haohao1331/ESC204-Team/milestone 2/Mechanical/Mechanical Build/Build Process before Milestone 1/2 Attaching Guide Rails.jpg

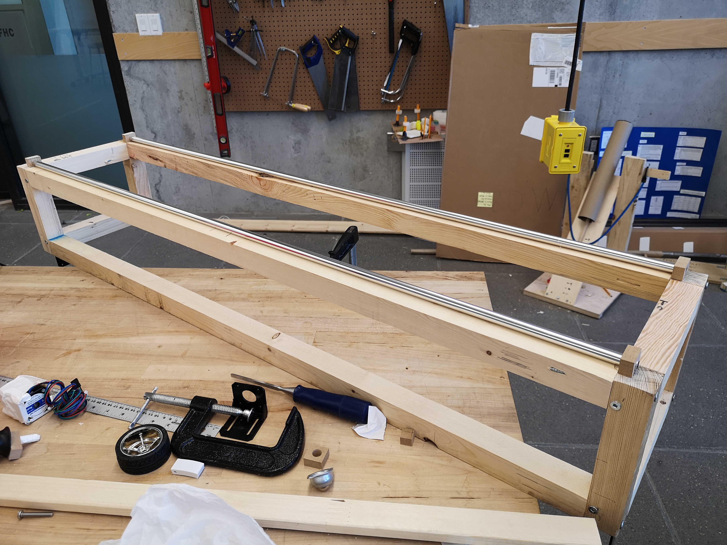
milestone 2/Mechanical/Mechanical Build/Build Process before Milestone 1/2 Attaching Guide Rails.jpg
