haohao1331/ESC204-Team/project proposal/camera testing/picam/test1/camera0.jpg

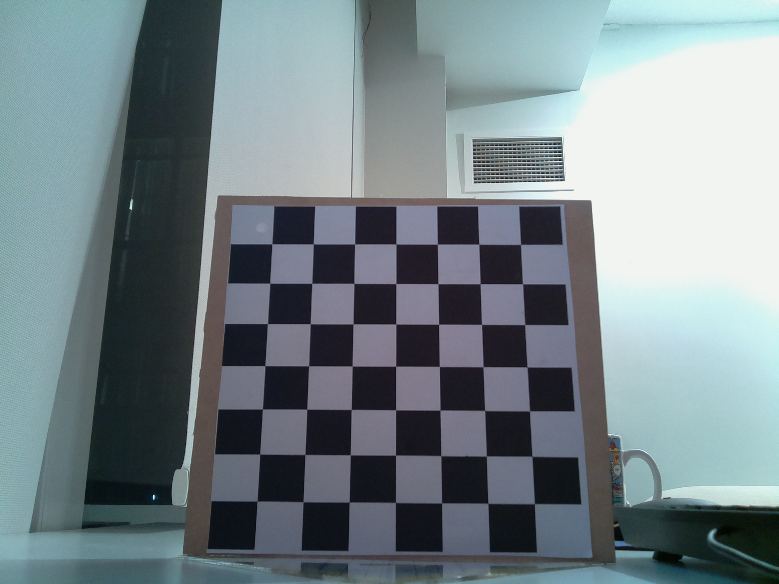
project proposal/camera testing/picam/test1/camera0.jpg
