haohao1331/ESC204-Team/README.md

# ESC204-Team
Team folder for ESC204, second year Engineering Science robotics course at U of Toronto. Files include design proposal, budget, python code for rhaspberry pi, CAD files.
