haohao1331/ESC204-Team/Design concept and project plan, informal presentation/Microcontroller selection.docx

# Microcontroller selection

## Metrics

Cost

Online resources

Compatability

CPU

RAM

Size

Power consumption
