haohao1331/ESC204-Team/Design concept and project plan, informal presentation/Project Timeline.xlsx

Week Starting Date | Week Number | Deliverables | Task to Accomplish
2020-02-03 | 5 |  | Finish Component Selection and start first round of purchasing.
2020-02-10 | 6 |  | Start to test component's performance
2020-02-17 | Reading Week | Design proposal | Start assembly, finish base, test camera recognition
2020-02-24 | 7 |  | Buy additional products, finish upper
2020-03-02 | 8 |  | Assembly, prepare for deliverable 1, be able to plug in under manual control
2020-03-09 | 9 | Milestone 1: Mobility | Prepare for deliverable 2
2020-03-16 | 10 | Milestone 2: Locating | Refine and further debug
2020-03-23 | 11 |  | Prepare for deliverable 3 and start report
2020-03-30 | 12 | Milestone 3: Final Design | Finsh report
2020-04-06 | 13 | Report, Video | Refine report before due date, finish a short video
Task assigment
Man Qiu | Designing and testing algorithms for computer vision
Richard | Desining and testing the base of the system
Leo | Designing and testing the upper body
