haohao1331/ESC204-Team/milestone 2/Electrical/motor driver connection.jpg

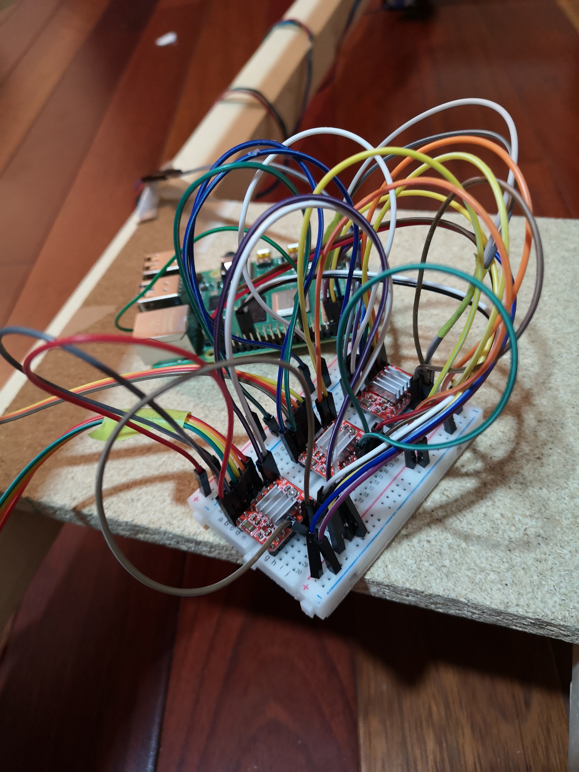
milestone 2/Electrical/motor driver connection.jpg
