haohao1331/ESC204-Team/milestone 2/Electrical/raspberry pi GPIO pins.jpg

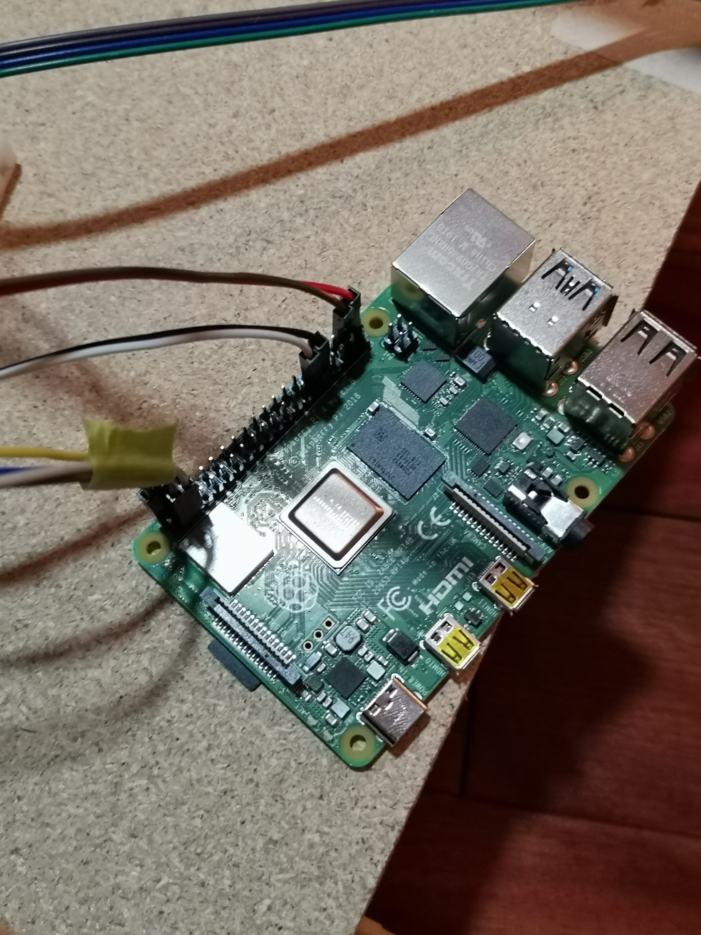
milestone 2/Electrical/raspberry pi GPIO pins.jpg
