haohao1331/ESC204-Team/milestone 2/Mechanical/Mechanical Build/Build Process before Milestone 1/18 Finished Design for Milestone 1.jpg

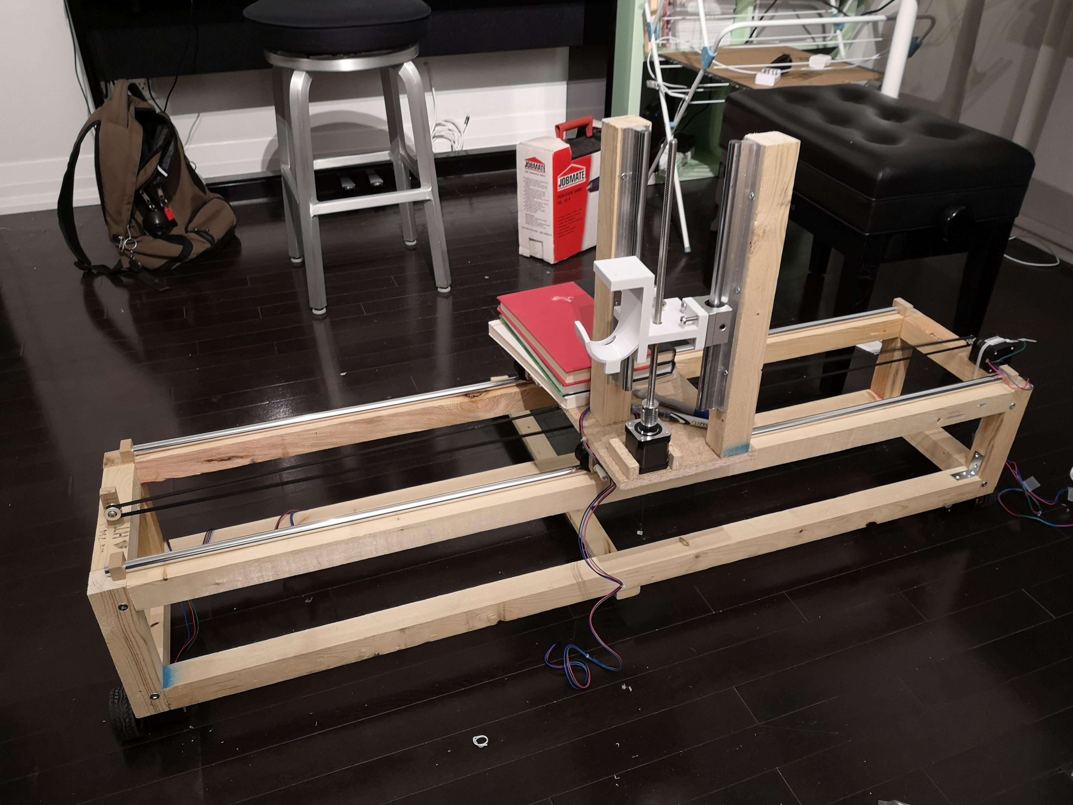
milestone 2/Mechanical/Mechanical Build/Build Process before Milestone 1/18 Finished Design for Milestone 1.jpg
