haohao1331/ESC204-Team/milestone 2/Mechanical/Mechanical Build/Final Mechanical Build/Finished Design for Milestone 2_5.jpg

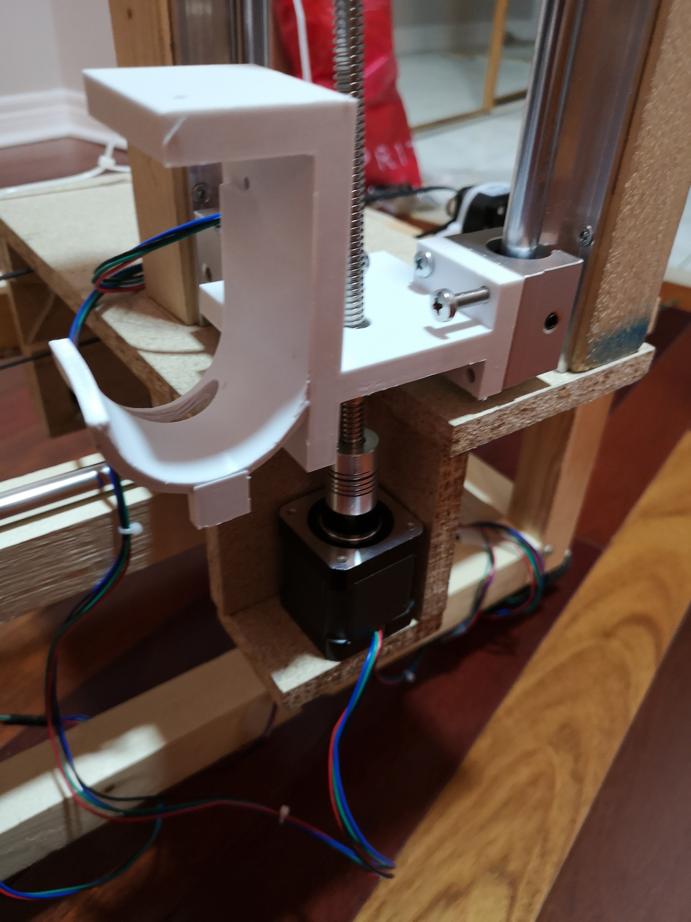
milestone 2/Mechanical/Mechanical Build/Final Mechanical Build/Finished Design for Milestone 2_5.jpg
