haohao1331/ESC204-Team/milestone 2/Mechanical/Mechanical Design/Gripper Design V1.0.jpg

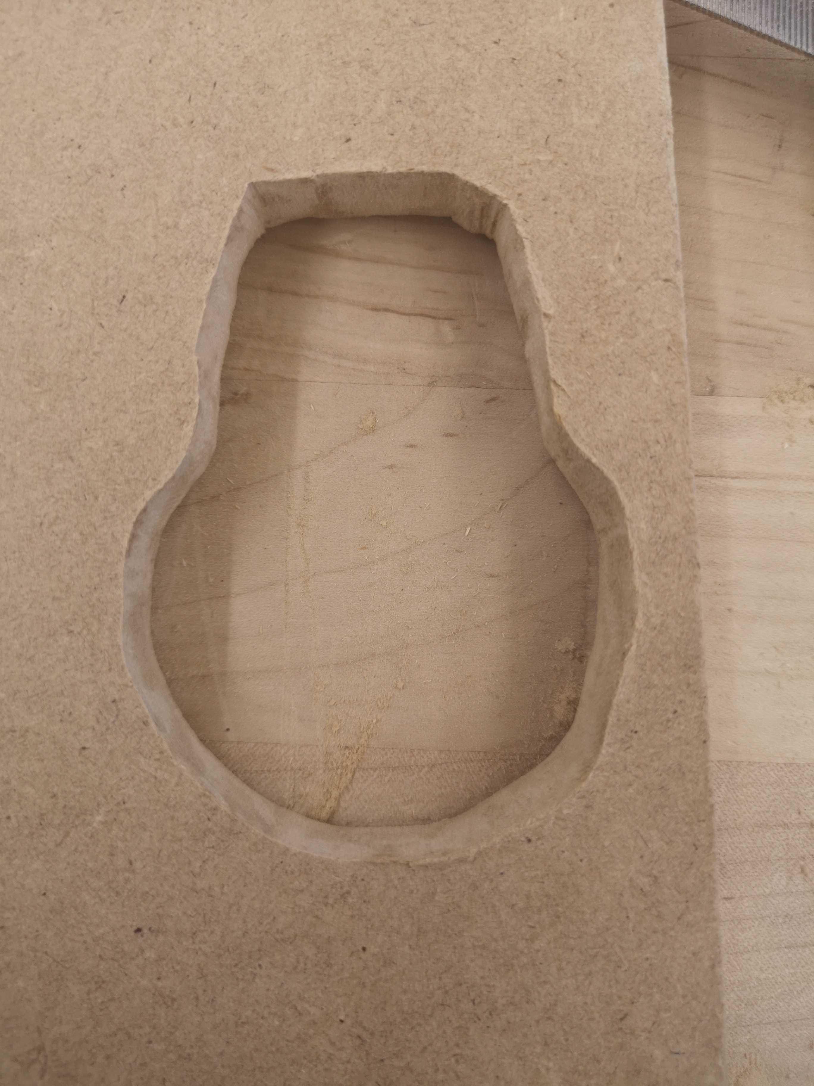
milestone 2/Mechanical/Mechanical Design/Gripper Design V1.0.jpg
