haohao1331/ESC204-Team/milestone 2/Mechanical/Storing and Transporting/Transporting the Finished Product.jpg

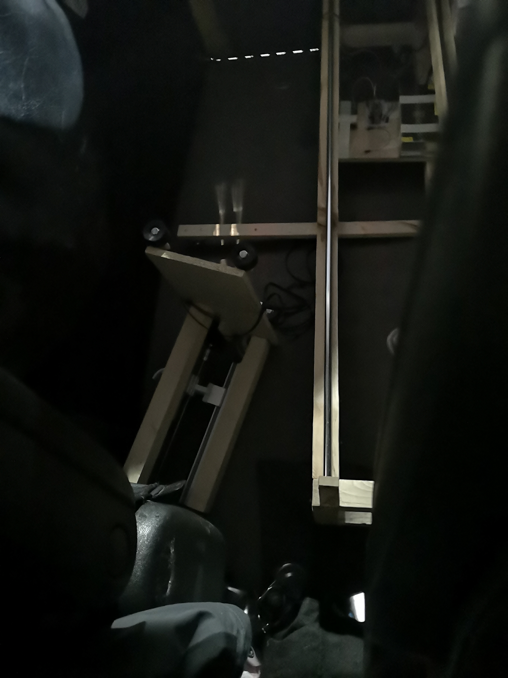
milestone 2/Mechanical/Storing and Transporting/Transporting the Finished Product.jpg
