haohao1331/ESC204-Team/milestone 2/Software/callibration.jpg

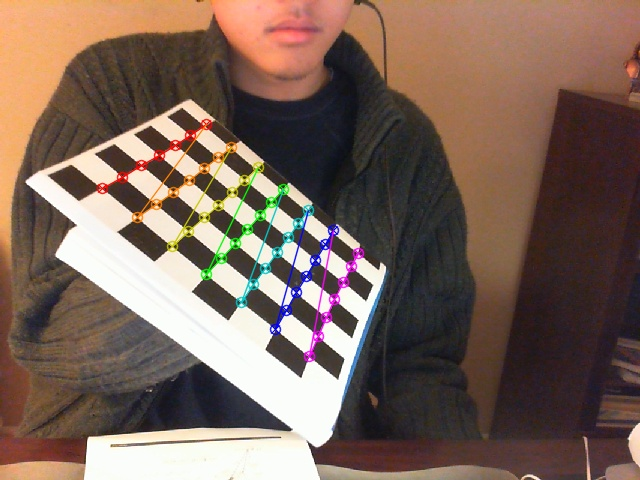
milestone 2/Software/callibration.jpg
