haohao1331/ESC204-Team/milestone 2/Software/sample output.PNG

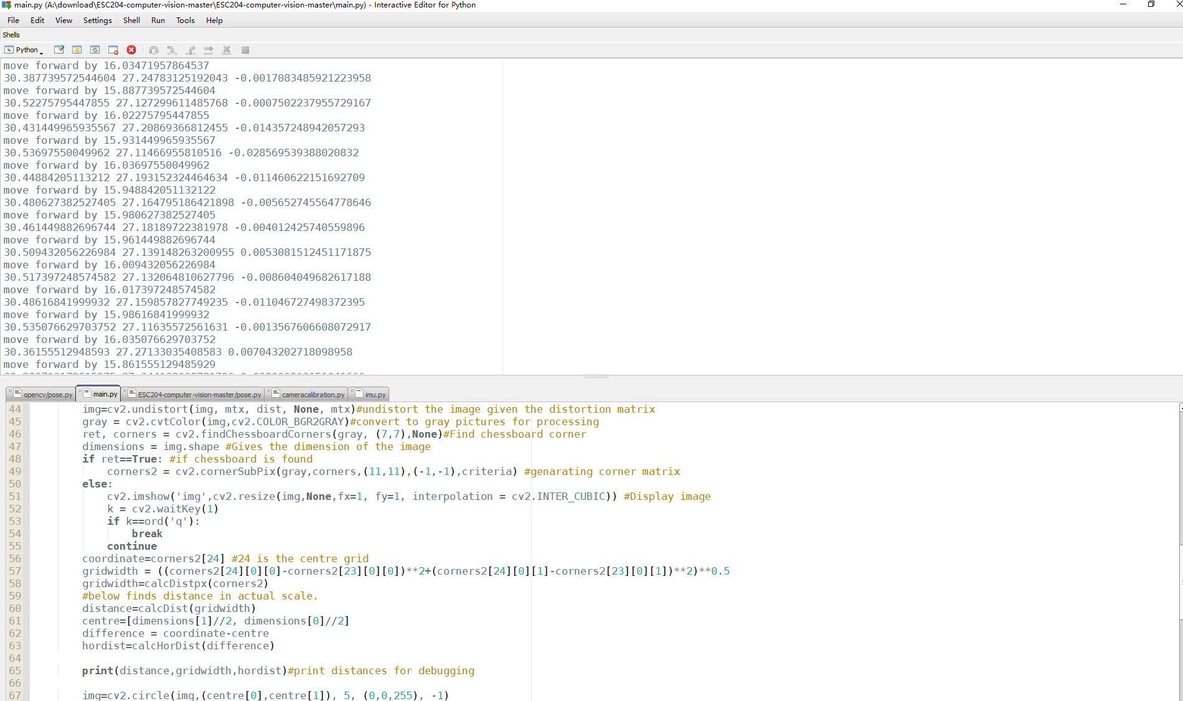
milestone 2/Software/sample output.PNG
