haohao1331/ESC204-Team/milestone 2/Software/undistorted image.PNG

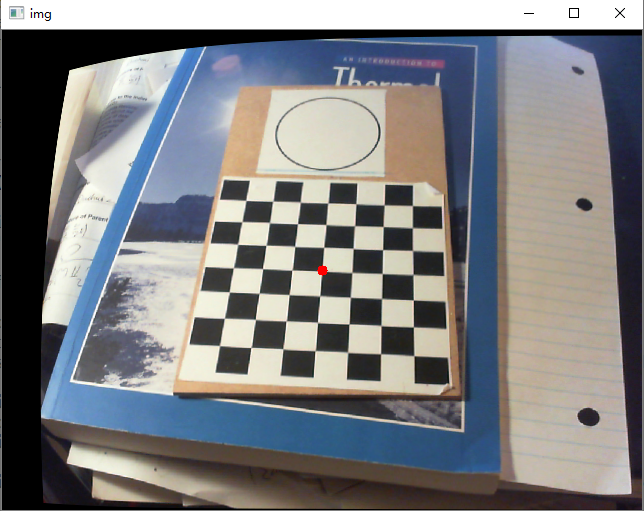
milestone 2/Software/undistorted image.PNG
