haohao1331/ESC204-Team/workshop2 deliverable/CAD 1.jpg

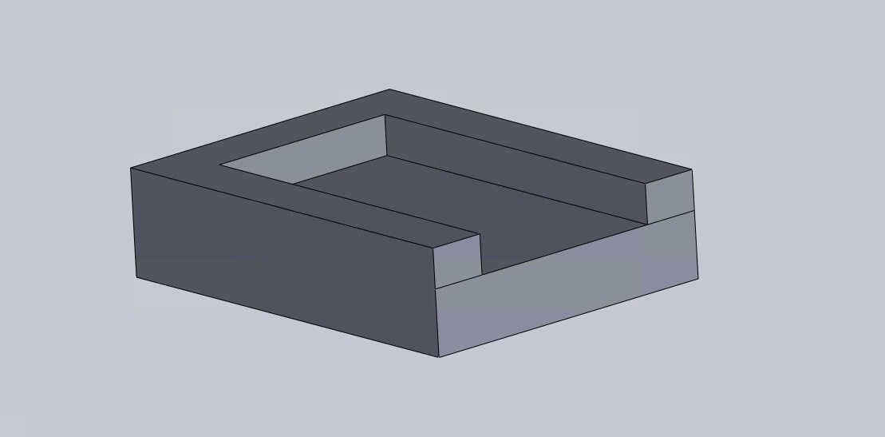
workshop2 deliverable/CAD 1.jpg
