haohao1331/ESC204-Team/workshop2 deliverable/CAD 2.png

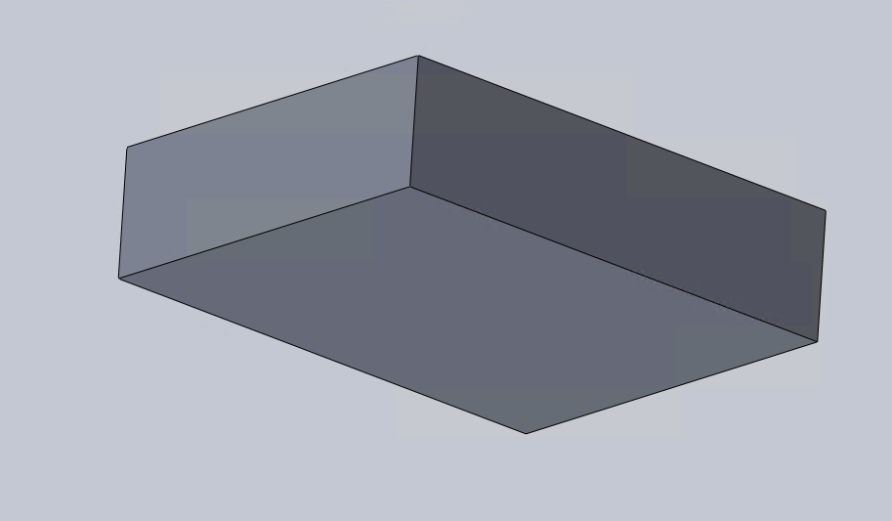
workshop2 deliverable/CAD 2.png
