haohao1331/ESC204-Team/workshop2 deliverable/CAD Sample.png

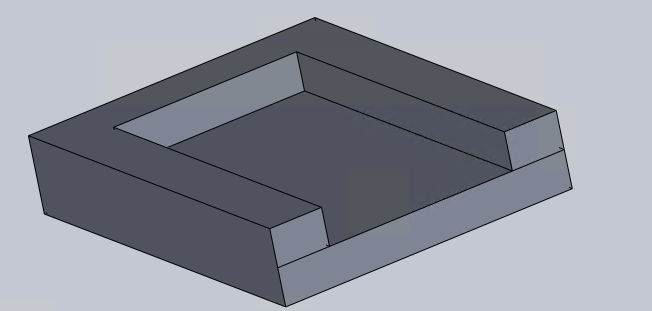
workshop2 deliverable/CAD Sample.png
