haohao1331/ESC204-Team/workshop2 deliverable/hand sketch.png

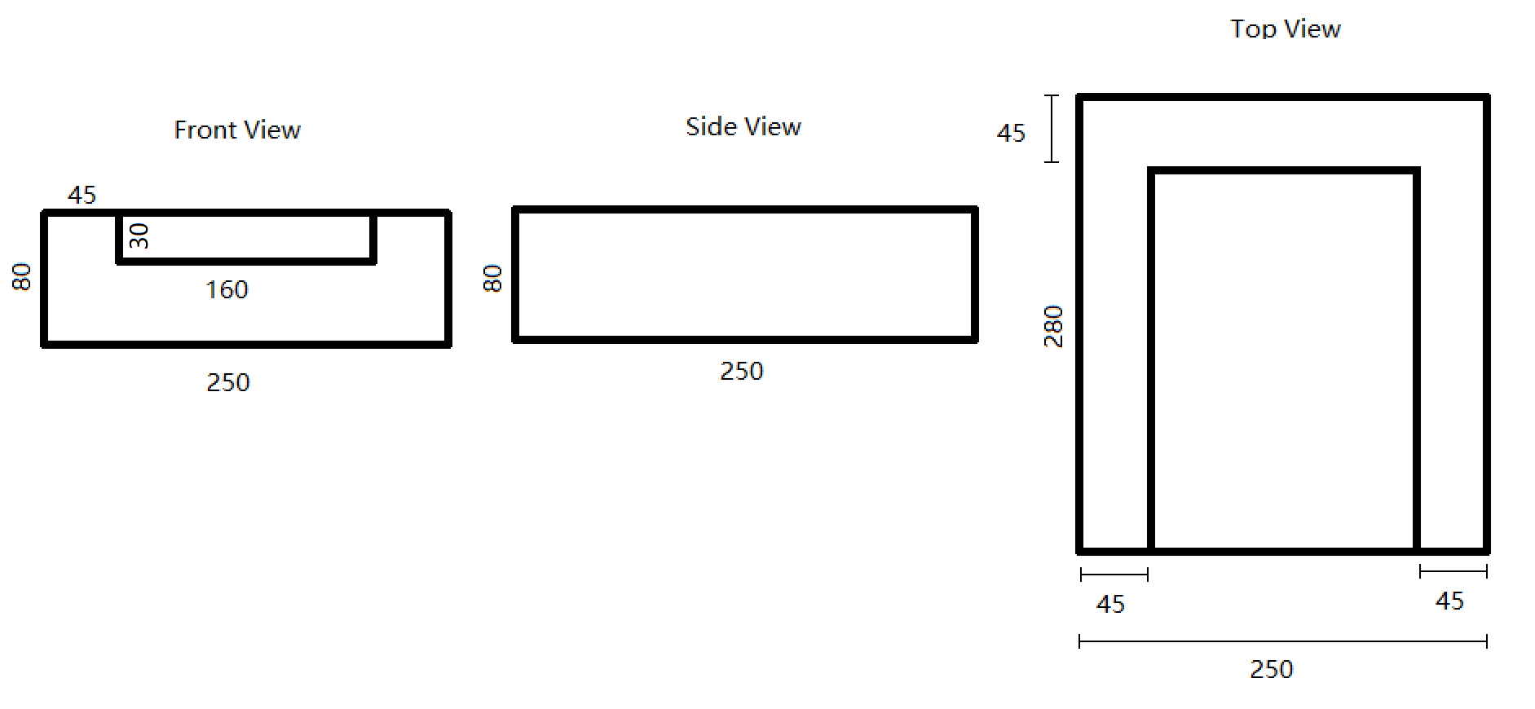
workshop2 deliverable/hand sketch.png
