haohao1331/ESC204-Team/shopping list.xlsx

Myhal material list: | https://utoronto.sharepoint.com/sites/fase-myhalfabrication/SiteAssets/FabFacMyhalCentre_StockMaterials_feb2019.pdf
myhal electronic website | https://utoronto.sharepoint.com/sites/fase-myhalfabrication/Lists/Electronics/AllItems.aspx
 |  |  |  | net cost:
Category | Compnent | Model | Quantity | Unit Cost | Total Cost | Actual Cost | Website | Image
Microcontroller | Raspberry Pi 4 | 4B 1GB RAM | 1 | $54.22 | $54.22 |  | Amazon
 | SD Card | 16 GB | 1 | $10 | $10 |  | Amazon
Mechanical | U Type Groove Pulley Rail Ball Bearing | 0840UU 8x40x20.7mm Nylon Coated U-Groove Guide Pulley Wheel Roller Bearing, U Type Groove Pulley Rail Ball Bearing, 4Pcs | 4 | $5.00 | $20.00 |  | Amazon
 | Timing Belt Set (with Pulley and Idler) | FULARR 5m Professional GT2 | 1 | $1.45 | $1.45 |  | LFF |  |  | https://www.aliexpress.com/item/32811768272.html
 | Wheel |  | 2 | $2.29 | $4.58 |  | LFF
 | Vertical Bearing Bracket | KFL08 | 1 | $3.91 | $3.91 |  | LFF
 | Printer Guide Rail Set | 30mm 8mm Diameter Lead Screw + Nut + 2 Guide Rails | 1 | $27.35 | $27.35 |  | LFF
 | Wheel Coupler | 5mm Hexagonal | 2 | $1.37 | $2.74 |  | LFF
 | Ball caster |  | 1 | $2.22 | $2.22 |  | LFF
 | Wooden Frame | Spruce 2'x2' | 25 | $0.54 | $13.50 |  | LFF
 | Wooden Board | Particle Board 1/2" | 4 | $0.90 | $3.60 |  | LFF
 | Aluminum 1/2 "" Pipe | Conduit Pipe | 3 | $4.36 | $13.08 |  | Home Hardware
 | 3D Printing | Charger Gripper Vertical Plate | 1 | $3.51 | $3.51 |  | LFF
 | Stepper Motor Mount |  | 2 | $5.63 | $11.26 |  | Amazon
Power Supply | Battery holder | AA Case 4 slots | 1 | $2.89 | $2.89 |  | LFF
 | 12 V 6 A Power Supply |  | 1 | $15.09 | $15.09 |  | LFF
 | Extension Cable |  | 1 | $4.49 | $4.49 |  | Home Hardware
 | Breadboard |  | 2 | $0.86 | $1.72 |  | LFF
 | 1.5 V AA Batteries |  | 4 | $6.25 | $25.00 |  | Home Hardware
Motor | Stepper Motor | Stepper NEMA 17 1.7 A | 4 | $13.93 | $55.72 |  | LFF
 | Servo Motor | MG995 | 1 | $4.80 | $4.80 |  | LFF
 | Motor Driver | A4988 | 5 | $1.83 | $9.15 |  | LFF
Sensor | MPU | Gikfun GY-521 MPU-6050 | 3 | $1.51 | $4.53 |  | LFF
 | Wire??? |  | ???
 | Corner brackets??? |  | ???
Camera | xxx |  | 1 | $40 | $40 |  | https://www.amazon.ca/LABISTS-Raspberry-Camera-Module-Acrylic/dp/B07TXKMPGH | https://www.amazon.ca/dp/B012V1HEP4?ascsubtag=UUacUdUnU80123YYwYg | https://www.amazon.ca/3-5-5V-Ultrasonic-Ranging-Compatible-HC-SR04/dp/B07SKGKKW3
Sensor | IR |  | 2 |  | 0 |  | https://www.amazon.ca/HC-SR04-Ultrasonic-Distance-Arduino-MEGA2560/dp/B01COSN7O6 | https://www.amazon.ca/Ultrasonic-HC-SR05-HY-SRF05-Distance-MEGA2560/dp/B07VMJWTND | https://www.aliexpress.com/item/32858363771.html
 | ultrasonic |  | 4 | 0.94-3 | 10 |  | https://www.aliexpress.com/item/32811614766.html | https://www.aliexpress.com/item/32800879575.html | https://www.amazon.ca/Gikfun-MPU-6050-Accelerometer-Gyroscope-EK1091x3C/dp/B07JPK26X2
 | gyroscope |  | 2 |  | 0 |  |  | https://www.amazon.ca/DSD-TECH-Accelerometer-Magnetometer-Communication/dp/B07TV4L6HT
Motor | STEPPERONLINE 5PCS Nema 17 Stepper Motor |  | 1 | $75.00 | $75.00 |  | https://www.amazon.ca/Stepper-63-74oz-42x39mm-Connector-Printer/dp/B07MDY5RX7
 | BIQU A4988 Compatible Stepper StepStick Motor Diver |  | 1 | $16.66 | $16.66 |  | https://www.amazon.ca/Longruner-LK02-Arduino-Professional-Mechanical/dp/B07NXP6HST
 | wheels |  | 1 | $20.00 | $20.00 |  | https://www.amazon.ca/HOSIM-Terrain-Replacement-Performance-Accessory/dp/B076HLKVBB
 | Wheels | ball caster | 2 | $2.22 | $4.44 |  | - ID: 180 - https://utoronto.sharepoint.com/sites/fase-myhalfabrication/Lists/Electronics/AllItems.aspx
Mechanical | Lead Screw for Z axis | 8mm diameter 300mm length + vertical bearing + coupler | 1 | $8.95 | $8.95
 | Guide rails for Z axis | 30 mm |  |  |  |  | https://3dprintingcanada.com/products/350mm-lead-screw-8mm-diameter?_pos=2&_sid=ca982d05e&_ss=r
 | Roller |  | 4 | $6.99 | $27.96
 | male/femal cable | arduino wires | 1 | $11.95 | $11.95 |  | https://www.servocity.com/0-250-bore-aluminum-set-screw-v-roller
 | mm cable | arduino wires |  | $0.06 | $0.00 |  | - we can coop with other teams - https://www.amazon.ca/Elegoo-120pcs-Multicolored-Breadboard-arduino/dp/B01EV70C78
Small components | ff cable | arduino wires |  | $0.06 | $0.00 |  | - myhal 买更便宜 - ID: 16, 50, 51 - https://utoronto.sharepoint.com/sites/fase-myhalfabrication/Lists/Electronics/AllItems.aspx
 | mf cable | arduino wires |  | $0.06 | $0.00
 | bread board | Elegoo 3pcs MB-102 Breadboard 830 Point | 1 | $10.98 | $10.98
 | bread board | bread board small | 1 | $0.86 | $0.86 |  | - 3pc $10.98, 可合资
 |  |  |  |  | 0 |  | - ID: 177 - https://utoronto.sharepoint.com/sites/fase-myhalfabrication/Lists/Electronics/AllItems.aspx
 |  |  |  |  | 0
 |  |  |  |  | 0
Battery |  |  |  |  | 0
 |  |  |  |  | 0
 |  |  |  |  | 0
 |  |  |  |  | 0
Power plug in |  |  |  |  | 0
 |  |  |  |  | 0
 |  |  |  |  | 0
 |  |  |  |  | 0
 |  |  |  |  | 0
 |  |  |  |  | 0
 |  |  |  |  | 0
 |  |  |  |  | 0
 |  |  |  |  | 0
 |  |  |  |  | 0
 |  |  |  |  | 0
 |  |  |  |  | 0
 |  |  |  |  | 0
 |  |  |  |  | 0
 |  |  |  |  | 0
 |  |  |  |  | 0
 |  |  |  |  | 0
