haohao1331/ESC204-Team/Design concept and project plan, informal presentation/Microcontroller selection.xlsx

Metrics | Alternatives | Cost | onlineresources | compatability | CPU | RAM | Power | bluetooth | USB ports | Pins | Software | Other | link
Cost | Raspberry Pi 4 model B | 46.95+ | complete and abundant https://projects.raspberrypi.org/en/projects/raspberry-pi-setting-up | good | Broadcom BCM2711, Quad core Cortex-A72 (ARM v8) 64-bit SoC @ 1.5GHz | 1,2,4 GB | 3.0A USB-C | 5 | 2 USB3 2 USB2 | 40 GPIO no analog read/write | NOOBS | - display port - camera port - 4-pole stereo audio and composite video port - with wifi | https://www.raspberrypi.org/products/raspberry-pi-4-model-b/specifications/
Online resources | ARDUINO MEGA 2560 REV3 | 32.75USD | complete and abundant https://www.arduino.cc/en/Tutorial/HomePage | good | clock speed at 16 MHz | 8kb | 5V | 0 | 0 | 54 digital IO 16 analog inputs | Arduino IDE | -13 built in LED -no need to relearn everything | https://store.arduino.cc/usa/mega-2560-r3
Compatability | ARDUINO UNO REV3 | $18.70USD | complete and abundant https://www.arduino.cc/en/Tutorial/HomePage | good | clock speed at 16 MHz | 2kb | 5V | 0 | 0 | 14 digital IO 6 analog input | Arduino IDE | -13 built in LED -no need to relearn everything - no need shiping | https://store.arduino.cc/usa/arduino-uno-rev3
CPU | DRAGONBOARD 410 C | 75USD | video tutorials on website https://developer.qualcomm.com/hardware/apq-8016e/tools | compatible with Arduino using an add-on mezzanine board | Quad-core ARM® Cortex® A53 at up to 1.2 GHz per core 64-Bit capable | 1GB | 6.8V-18V WM24P6-12-A-QL | 4.1 | 4 | One 40-pin Low Speed (LS) expansion connector One 60-pin High Speed (HS) expansion connector | Linux Android | - video processor - camera support - additional audio - 6 LED indicators - with wifi | https://www.arrow.com/en/products/dragonboard410c/arrow-development-tools
RAM
Size
Power consumption
 | Alternatives | Raspberry Pi 4 model B | ARDUINO MEGA 2560 REV3 | ARDUINO UNO REV3 | DRAGONBOARD 410 C
 | Cost | 46.95+ | 32.75USD | $18.70USD | 75USD
 | onlineresources | complete and abundant https://projects.raspberrypi.org/en/projects/raspberry-pi-setting-up | complete and abundant https://www.arduino.cc/en/Tutorial/HomePage | complete and abundant https://www.arduino.cc/en/Tutorial/HomePage | video tutorials on website https://developer.qualcomm.com/hardware/apq-8016e/tools
 | compatability | good | good | good | compatible with Arduino using an add-on mezzanine board
 | CPU | Broadcom BCM2711, Quad core Cortex-A72 (ARM v8) 64-bit SoC @ 1.5GHz | clock speed at 16 MHz | clock speed at 16 MHz | Quad-core ARM® Cortex® A53 at up to 1.2 GHz per core 64-Bit capable
 | RAM | 1,2,4 GB | 8kb | 2kb | 1GB
 | Power | 3.0A USB-C | 5V | 5V | 6.8V-18V WM24P6-12-A-QL
 | bluetooth | 5 | 0 | 0 | 4.1
 | USB ports | 2 USB3 2 USB2 | 0 | 0 | 4
 | Pins | 40 GPIO no analog read/write | 54 digital IO 16 analog inputs | 14 digital IO 6 analog input | One 40-pin Low Speed (LS) expansion connector One 60-pin High Speed (HS) expansion connector
 | Software | NOOBS | Arduino IDE | Arduino IDE | Linux Android
 | Other | - display port - camera port - 4-pole stereo audio and composite video port - with wifi | -13 built in LED -no need to relearn everything | -13 built in LED -no need to relearn everything - no need shiping | - video processor - camera support - additional audio - 6 LED indicators - with wifi
 | link | https://www.raspberrypi.org/products/raspberry-pi-4-model-b/specifications/ | https://store.arduino.cc/usa/mega-2560-r3 | https://store.arduino.cc/usa/arduino-uno-rev3 | https://www.arrow.com/en/products/dragonboard410c/arrow-development-tools
