haohao1331/ESC204-Team/Design concept and project plan, informal presentation/Motor and Actuator Selection.xlsx

Sheet: Actuator
 | Timing Belt | Ball Screw | Rack and Pinion | Electric Cylinder
Cost | partly 3D printable | 3D printable | 3D printable | Expensive
Reliability | Reliable | Sudden acceleartion can cause damage | Robust, but requires cleaniness and lubrication | Reliable
Efficiency | High (85%) | Very high (90%) | Very high (97%) | Inefficient
Accuracy | To be tested | To be tested | To be tested | To be tested
Manufacturability | Needs non-3D-printed parts | May need guiding rails with ball bearings | Can have joined profile rails to make longer length | Must be purchased
Thrust force | High | High | High | Very high
Plan for Converge
0. Initial research
1.Test out accuracy and reliability with 3D printed scaled-down prototypes and stepper motor from workshop
2. Research and select constructing methods (extend of 3D printing)
3. Construct and test the performance (reliability, accuracy, repeatbility) for different purposes (X,Y,Z movements)

Sheet: Motor
 | Parallax Feedback 360° High Speed Servo | Replicator NEMA 17 2/2X
Cost | $37.43 | $39.99
Reliability
Accuracy | Not mentioned | 200 steps per revolution, 1.8 degrees +- 5%
Maintenance
Usage simplicity | Complicated setup with PWM tuning
Continuous Operating Torque | 30.5 in.-oz | 8.9 in.-oz
Max Speed | 120 RPM | 750 RPM
Voltage/Current | 6V 1200 mA | 12V 350 mA
Size | 2.15 x 1.46 x 0.79 | 2 3/4'' x 1 3/4'' x 1 3/4''
Test for Converging
Note: can only be done after material and dimensions of track is constructed/converged
0. Initial research
1. Calculate desire accelaration, desired speed, desired RPM
2. Calculate torque requirement
3. Set feasible budget
4. Collect factory specifications, look up suitable motors, check online reputation of the manufacturer
5. Compare rated torque with the estimated torque requirement
6. Purchase and test the device's effectiveness with the actual track (holding torque performance, accuracy, and reliability)
