haohao1331/ESC204-Team/Design concept and project plan, informal presentation/motor selection.xlsx

Motor | Polar/Bipolar | Voltage | Amp | Price | Source | Weight | Holding Torque | Step Angle | Frame Size | Body Length | Shaft Diameter | Shaft Length | D-cut Length | # of Leads
Longruner Nema 17 | bipolar | 12 | 2 | $23.49 | https://www.amazon.ca/Stepper-Longruner-Bipolar-Printer-17HS13-0404S/dp/B06Y6BG9TK?s=electronics | 390g | 59Ncm | 1.8 | 42mm x 42mm | 48mm | 5mm | 24 | 14mm | 4
Dual Shaft Nema 23 |  |  | 3.0-4.24 | $29.99 | https://www.amazon.ca/Stepper-1-8deg-1-26Nm-178-4oz-Milling/dp/B07CJNMVY8 | 0.7kg | 1.26Nm |  | 57 x 57mm | 56mm | 6.35mm | front: 21 rear: 15 |  | 8
STEPPERONLINE Nema 23 |  |  |  | $23.99 | https://www.amazon.com/STEPPERONLINE-Stepper-178-5oz-1-26Nm-Stepping/dp/B00PNEPF5I | 0.7kg | 1.26Nm
Twotrees Stepper Motor Nema 17 |  |  |  | $8.99 | https://www.amazon.com/Twotrees-Stepper-17HS4401-Connector-Printer/dp/B07THK76QQ |  | 42Ncm
STEPPERONLINE Nema 17 |  |  |  | $13.99 | https://www.amazon.com/STEPPERONLINE-Stepper-Bipolar-Connector-compatible/dp/B00PNEQKC0 | 370g | 59Ncm
Bundle name | link | price | holding torque
(Pack of 4pcs) NEMA17 | https://www.amazon.com/NEMA17-Stepper-Torque-Bipolar-MOTOU/dp/B07RZHWYQ9 | $28.99 | 29Ncm
BIQU A4988 Compatible Stepper StepStick Motor Diver Module | https://www.amazon.com/BIQU-Compatible-Stepper-StepStick-Controller/dp/B01FFGAKK8 | $16.20
ECO-WORTHY 5pcs Nema 17 | https://www.amazon.ca/ECO-WORTHY-Torque-Stepper-Connectors-Printer/dp/B0778RW1QK | $37.65 | 26Ncm
STEPPERONLINE 5PCS Nema 17 Stepper Motor | https://www.amazon.com/STEPPERONLINE-Stepper-63-74oz-Connector-Extruder/dp/B07LCHHQ97 | $45.99 | 45Ncm | Ken - 1 ?
