haohao1331/ESC204-Team/CAD Files/Gripper.step

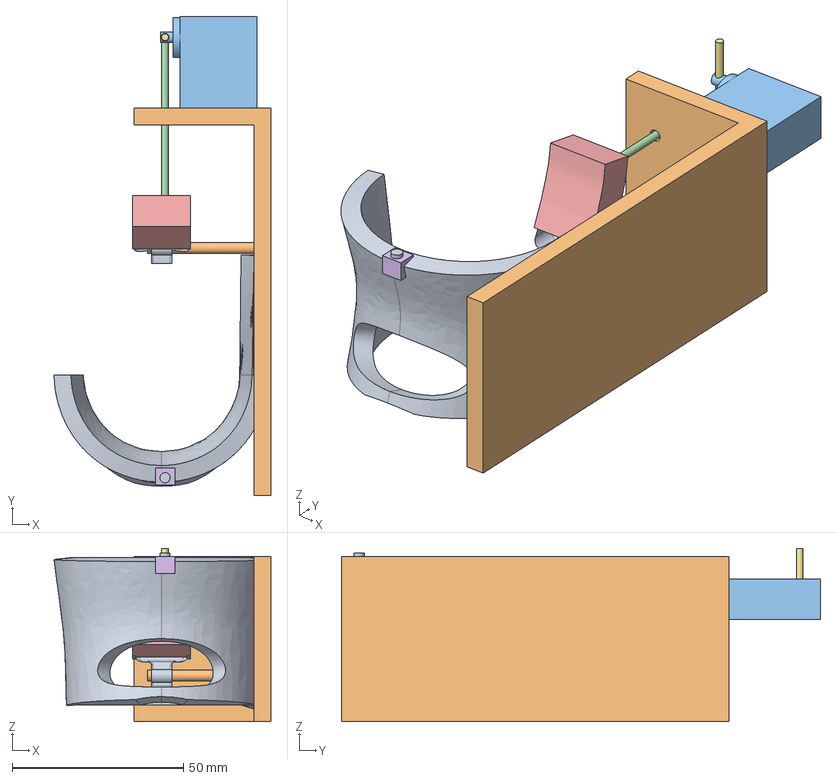
[picture p44: CAD file, 2020-05-06]
CAD Files/Gripper.step
63.3 x 139.7 x 50.5 mm
Handle
