haohao1331/ESC204-Team/Part1.SLDPRT

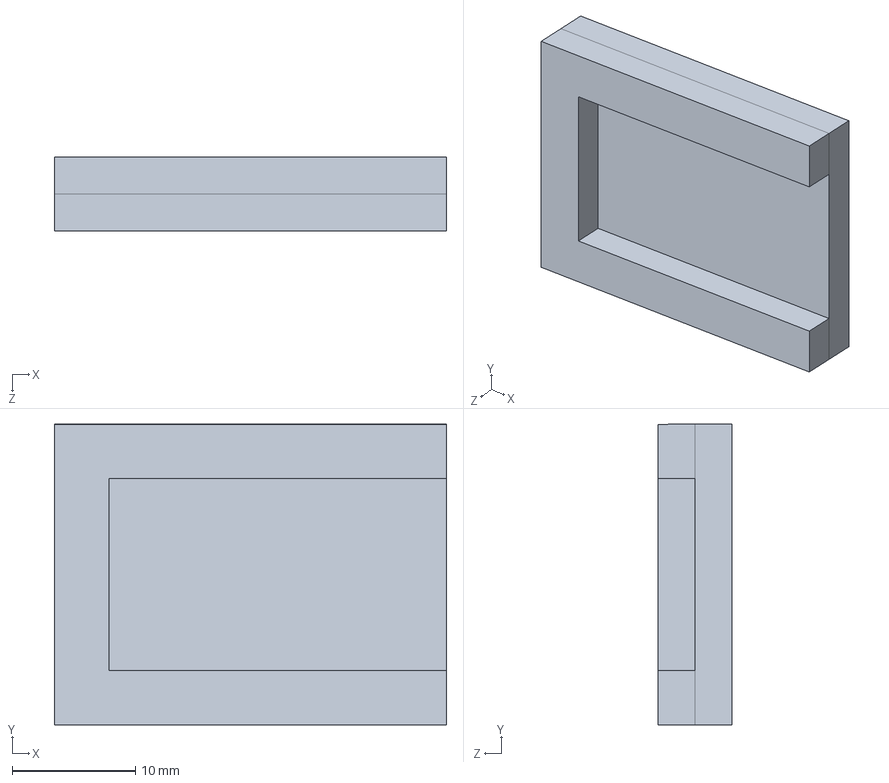
[picture p45: CAD file, 2020-05-06]
Part1.SLDPRT
31.9 x 24.4 x 6.00 mm
