haohao1331/ESC204-Team/(list of files, cad)

Other CAD files:
milestone 2/Mechanical/Mechanical Design/Gripper Design V2.0.step
