haohao1331/ESC204-Team/Pi Instructions.docx

General Info

username: pi

password: Aa123456

Network name: PiNetwork

Network password: ESC204LMR

SSH to Pi

1. connect power supply to pi
2. wait approx 75 seconds for pi to boot up
3. go to wifi connections on your device, connect to PiNetwork
4. enter password ESC204LMR
5. On windows: using putty, connect to ip address: 192.168.4.1
6. enter username: pi
7. enter password: Aa123456
8. you are now in the /pi/home folder

For reference about SSH: https://www.raspberrypi.org/documentation/configuration/wireless/access-point.md

VNC into Pi (requires monitor and keyboard)

1. connect pi to power supply, mouse, keyboard, monitor
