haohao1331/ESC204-Team/milestone 2/Mechanical/Mechanical Build/Build Process before Milestone 1/17 Attaching Timing Belt to Horizontal Plate.MOV.docx

https://drive.google.com/open?id=14n81vQDnXpxONBj6bOPktuXtNarzEZNR
