haohao1331/ESC204-Team/milestone 2/Mechanical/Mechanical Build/Build Process before Milestone 1/8 Making a Right-angle Drill.MOV.docx

https://drive.google.com/open?id=1Pzqa9M0KXlKmqwDiZU5a-7OM4rtdWjJA
