haohao1331/ESC204-Team/milestone 2/Mechanical/Mechanical Build/Improvements after Milestone 1/3 Drilling Holes for Adjustable Wheels on the Horizontal Plate.MOV.docx

https://drive.google.com/open?id=1GMNSUJJminSkk5iRTRM3arfrX791jLaI
