haohao1331/ESC204-Team/milestone 2/Mechanical/Mechanical Build/Build Process before Milestone 1/6 Clamping the Horizontal in Preparation for Drilling.jpg

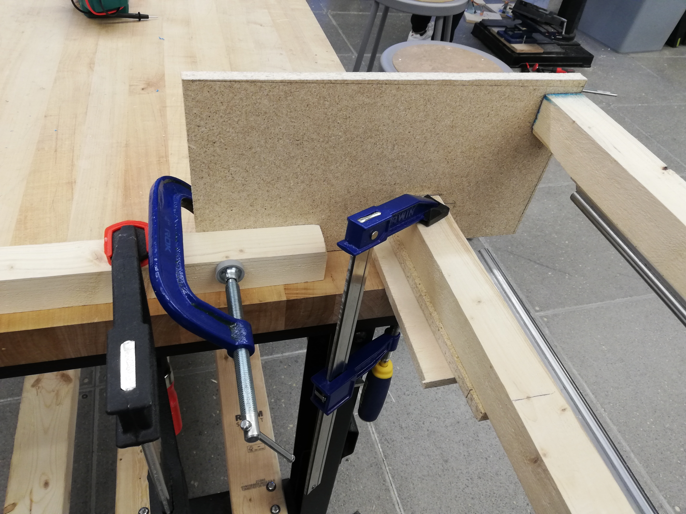
milestone 2/Mechanical/Mechanical Build/Build Process before Milestone 1/6 Clamping the Horizontal in Preparation for Drilling.jpg
