haohao1331/ESC204-Team/milestone 2/Mechanical/Mechanical Build/Build Process before Milestone 1/7 Assembling the Horizontal Plate.jpg

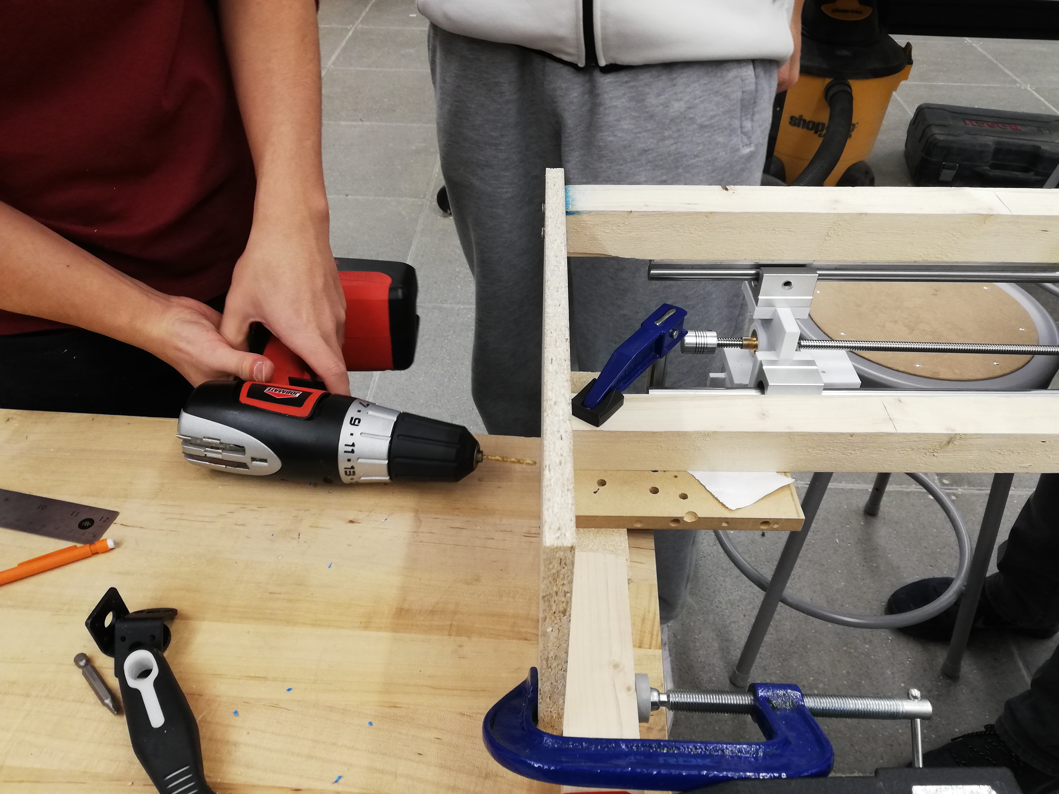
milestone 2/Mechanical/Mechanical Build/Build Process before Milestone 1/7 Assembling the Horizontal Plate.jpg
