haohao1331/ESC204-Team/milestone 2/Mechanical/Mechanical Build/Build Process before Milestone 1/9 Protoyping Vertical Plate.jpg

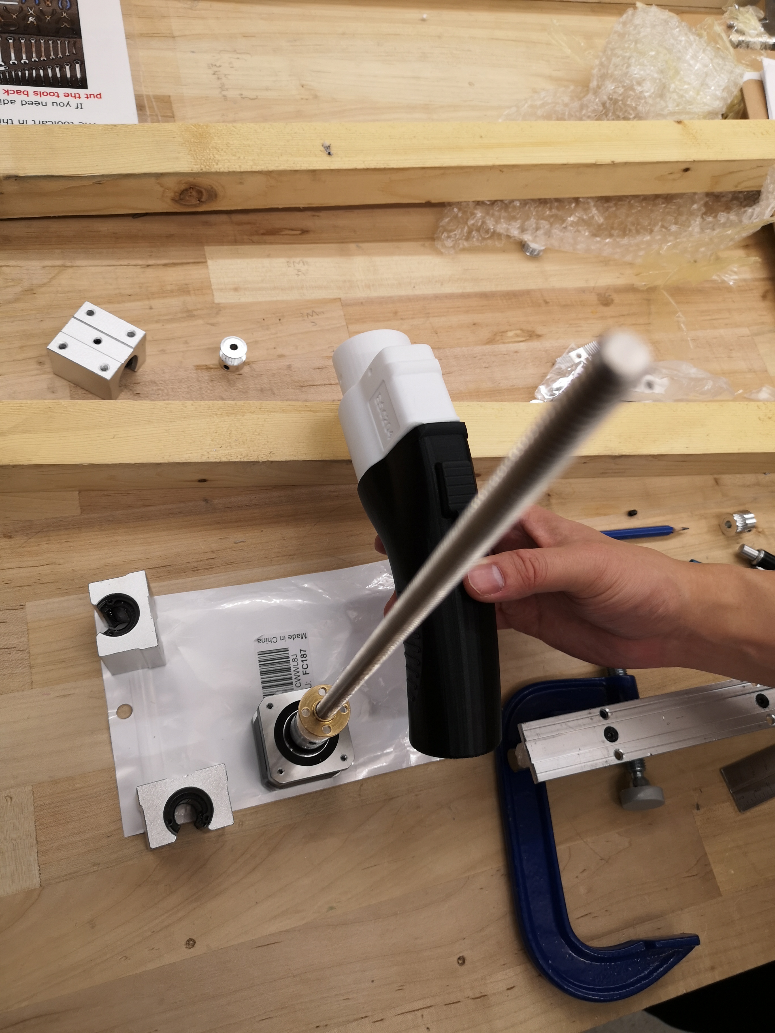
milestone 2/Mechanical/Mechanical Build/Build Process before Milestone 1/9 Protoyping Vertical Plate.jpg
