haohao1331/ESC204-Team/milestone 2/Mechanical/Mechanical Build/Build Process before Milestone 1/10 Prototyping Vertical Plate 2.jpg

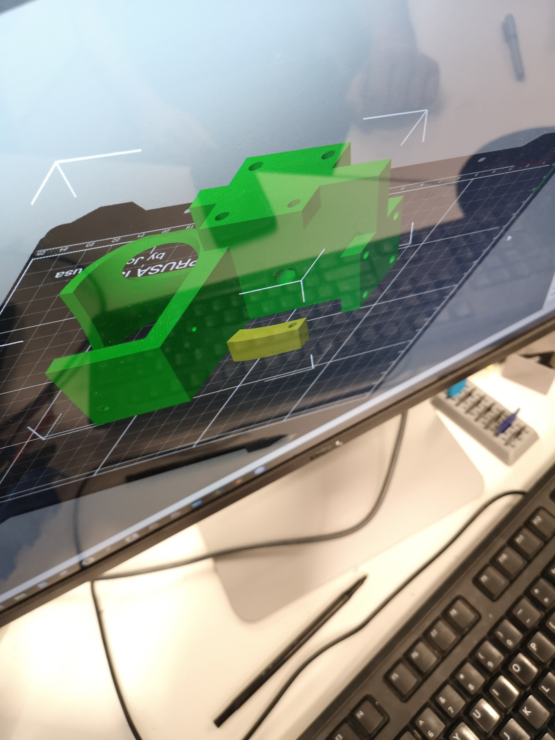
milestone 2/Mechanical/Mechanical Build/Build Process before Milestone 1/10 Prototyping Vertical Plate 2.jpg
