haohao1331/ESC204-Team/milestone 2/Mechanical/Mechanical Build/Build Process before Milestone 1/11 Enlarging the Drill Hole in Vertical Plate.jpg

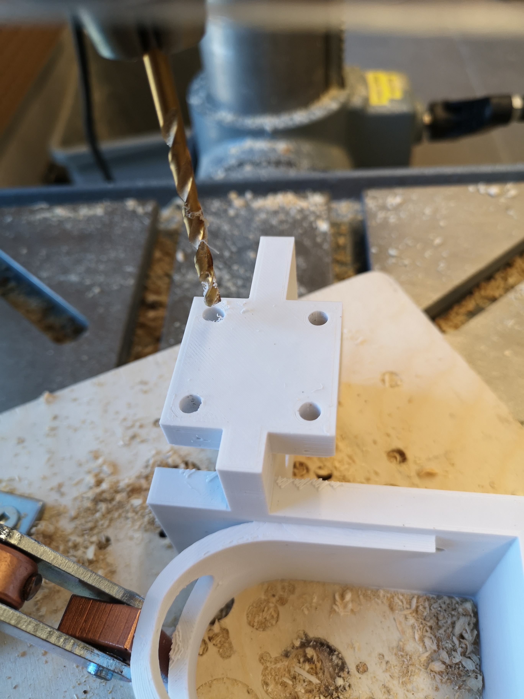
milestone 2/Mechanical/Mechanical Build/Build Process before Milestone 1/11 Enlarging the Drill Hole in Vertical Plate.jpg
