haohao1331/ESC204-Team/milestone 2/Mechanical/Mechanical Build/Build Process before Milestone 1/12 Assembling the Vertical Plate.jpg

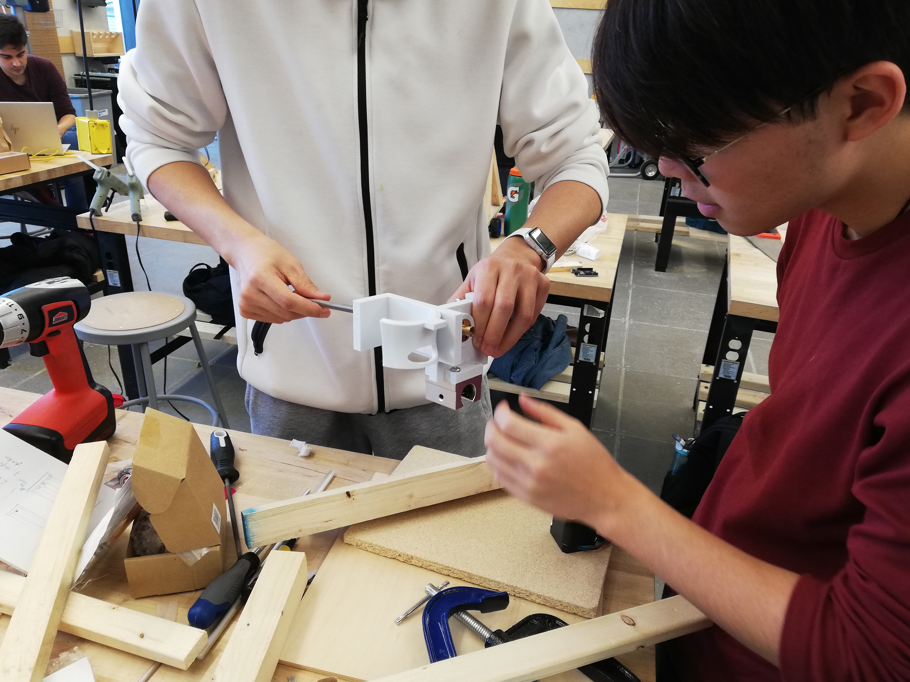
milestone 2/Mechanical/Mechanical Build/Build Process before Milestone 1/12 Assembling the Vertical Plate.jpg
