haohao1331/ESC204-Team/milestone 2/Mechanical/Mechanical Build/Improvements after Milestone 1/2 Drilling Holes for Guide Rail Attachments.jpg

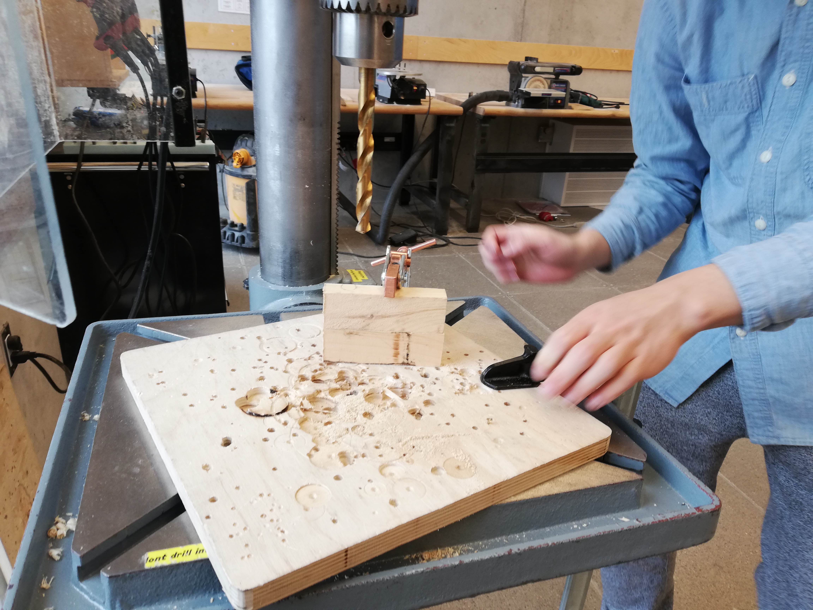
milestone 2/Mechanical/Mechanical Build/Improvements after Milestone 1/2 Drilling Holes for Guide Rail Attachments.jpg
