haohao1331/ESC204-Team/milestone 2/Mechanical/Mechanical Build/Improvements after Milestone 1/4 Drilling Holes for Adjustable Wheels on the Horizontal Plate.jpg

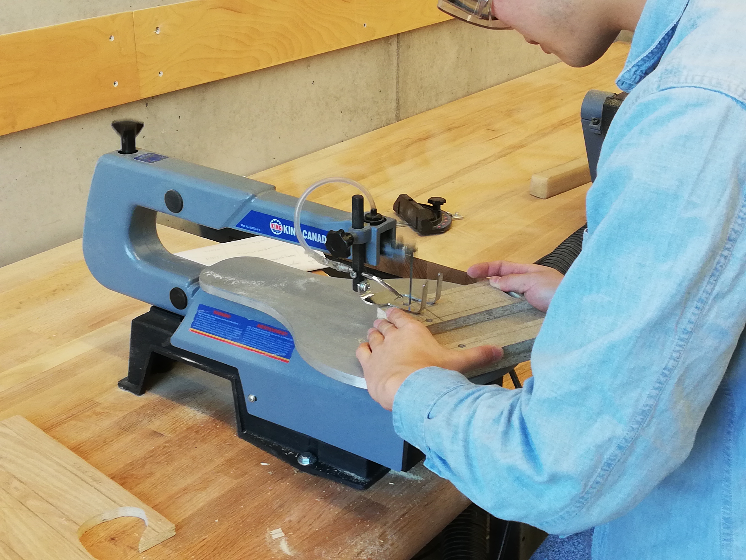
milestone 2/Mechanical/Mechanical Build/Improvements after Milestone 1/4 Drilling Holes for Adjustable Wheels on the Horizontal Plate.jpg
