haohao1331/ESC204-Team/milestone 2/Mechanical/Mechanical Build/Improvements after Milestone 1/6 Attaching Reinforced Adjustable Stand Timing Belt Idler Pulley.jpg

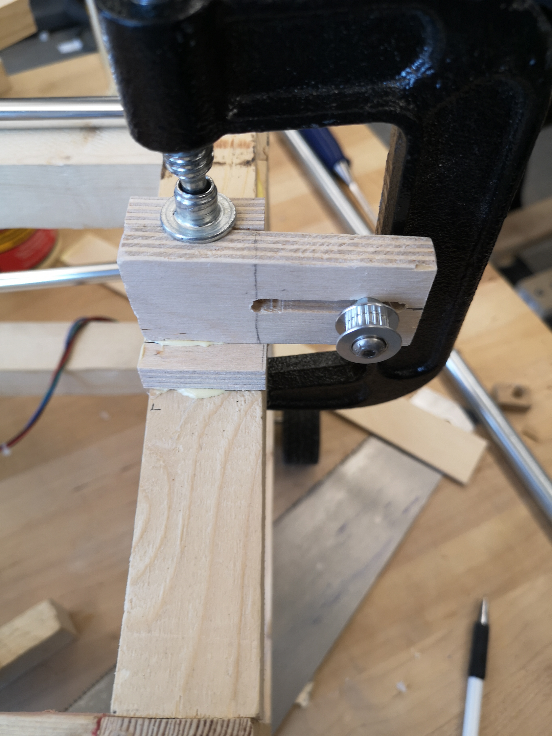
milestone 2/Mechanical/Mechanical Build/Improvements after Milestone 1/6 Attaching Reinforced Adjustable Stand Timing Belt Idler Pulley.jpg
