haohao1331/ESC204-Team/milestone 2/Mechanical/Mechanical Build/Improvements after Milestone 1/7 Attaching Reinforced Timing Belt Motorized Pulley and Guide Rail Holder.jpg

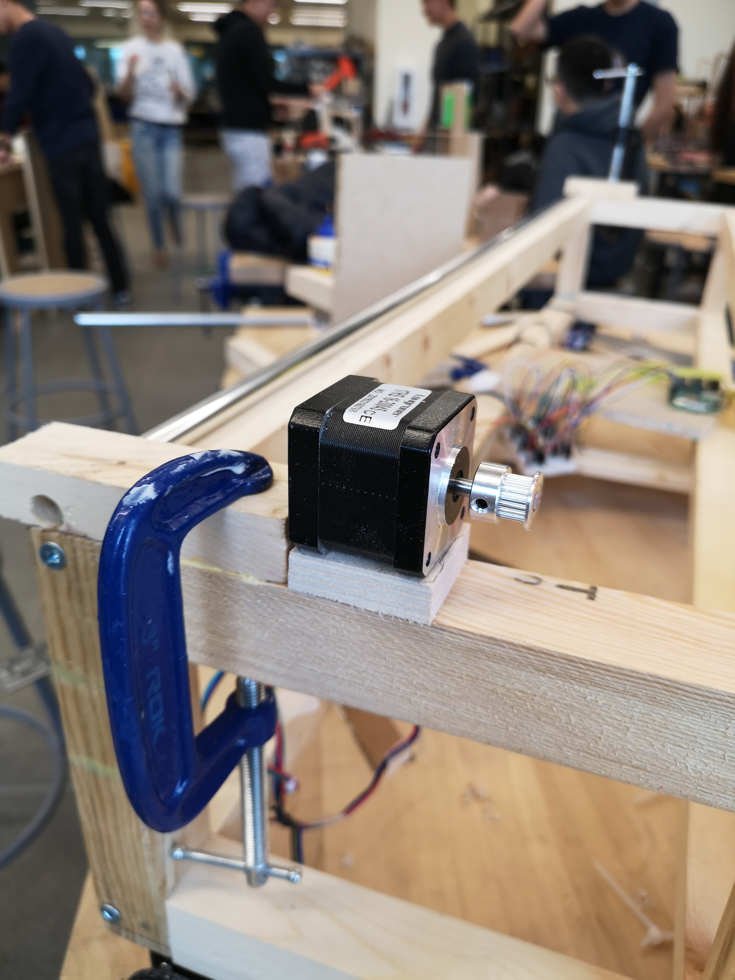
milestone 2/Mechanical/Mechanical Build/Improvements after Milestone 1/7 Attaching Reinforced Timing Belt Motorized Pulley and Guide Rail Holder.jpg
