haohao1331/ESC204-Team/milestone 2/Overall Performance/Milestone 1 Videos.docx

https://drive.google.com/drive/folders/1HQz6jVDMT7tqM27iEY2V0v4xCvzLkdot
