haohao1331/ESC204-Team/milestone 2/Overall Performance/Quick snapshot of beginning of milestone1.mp4.docx

https://drive.google.com/file/d/1sYwxrqCv60UlbV5_0llzAa4xkls5cSYj/view
