haohao1331/ESC204-Team/milestone 2/Overall Performance/Robot demo motor working.mp4.docx

https://drive.google.com/file/d/1sa3gdZFc-xCA5cI1TzytoEpZRWJ5iwoR/view
