haohao1331/ESC204-Team/milestone 2/Mechanical/Mechanical Build/Improvements after Milestone 1/10 Testing Movement of Timing Belt.mp4.docx

https://drive.google.com/open?id=1sSPBEWetW_3-gh7U7AlCG50NXZpgm54p
