haohao1331/ESC204-Team/milestone 2/Electrical/leo testing SSH.jpg

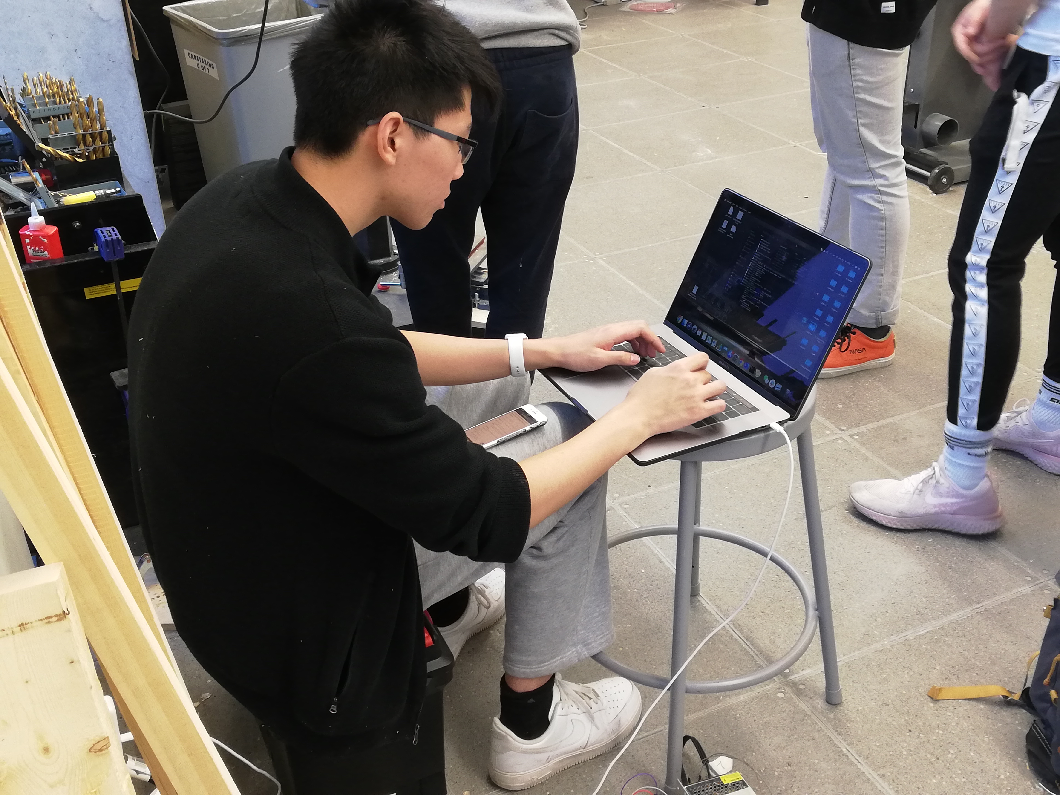
milestone 2/Electrical/leo testing SSH.jpg
