haohao1331/ESC204-Team/milestone 2/Mechanical/Mechanical Build/Build Process before Milestone 1/5 Testing Leveling of Horizontal Plate.jpg

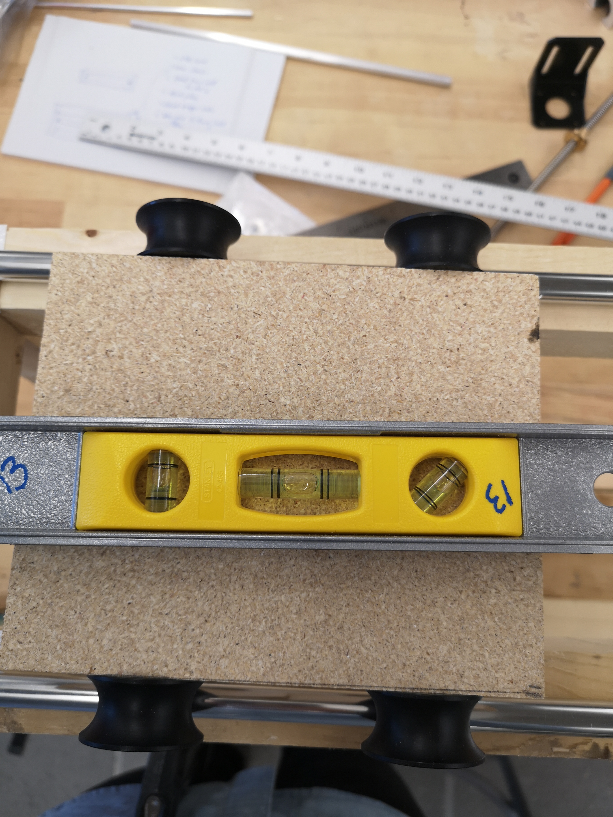
milestone 2/Mechanical/Mechanical Build/Build Process before Milestone 1/5 Testing Leveling of Horizontal Plate.jpg
