haohao1331/ESC204-Team/milestone 2/Mechanical/Mechanical Build/Build Process before Milestone 1/15 Testing the Functionality of Vertical Plate and Gripper 1.JPG

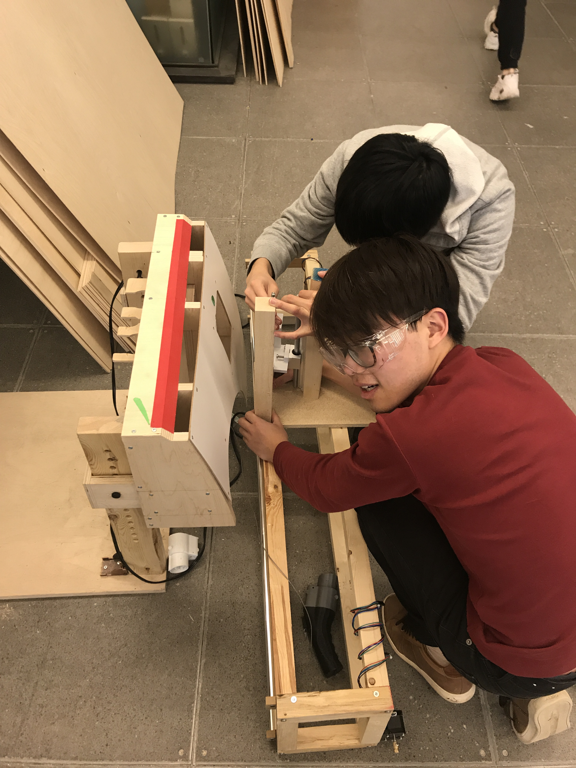
milestone 2/Mechanical/Mechanical Build/Build Process before Milestone 1/15 Testing the Functionality of Vertical Plate and Gripper 1.JPG
