haohao1331/ESC204-Team/project proposal/camera testing/picam/test2/camera50.jpg

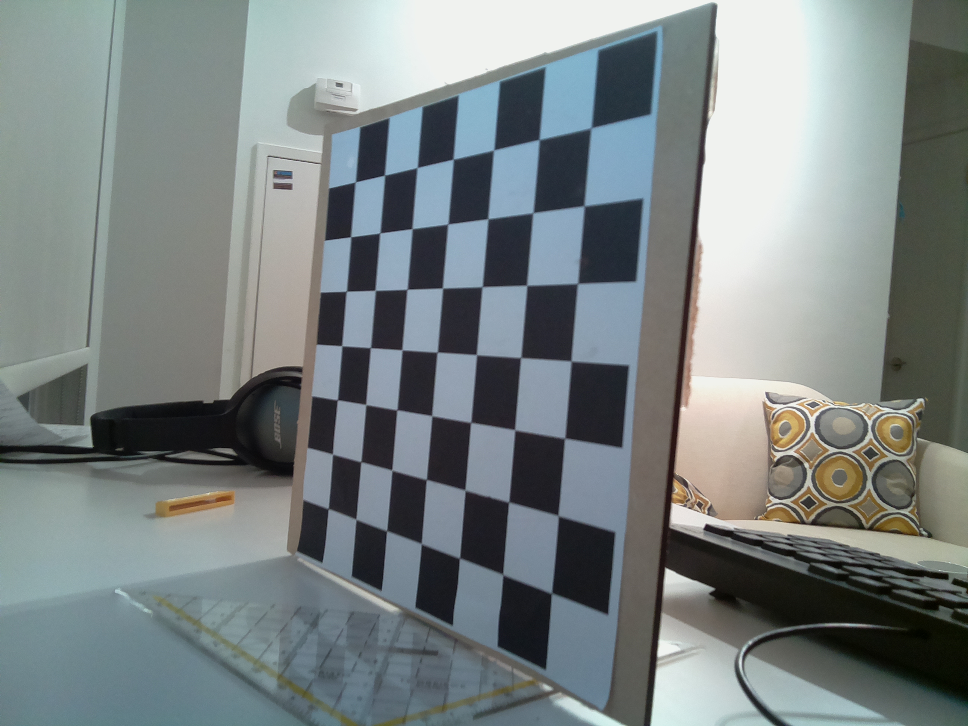
project proposal/camera testing/picam/test2/camera50.jpg
