haohao1331/ESC204-Team/Design concept and project plan, informal presentation/ESC204 Design concept and project plan meeting.pdf

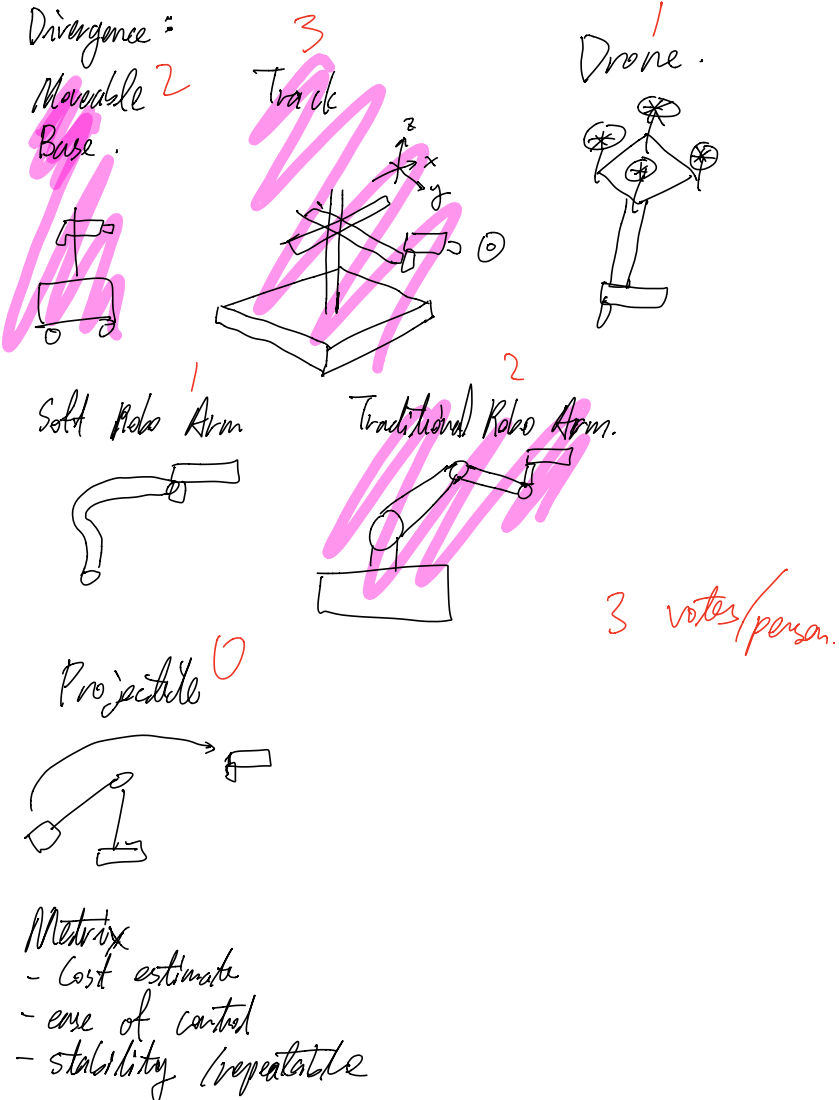
[picture p78: page 1]
Divergence; Moveable2; Truck; Base; ggp; TraditionalRoboArm JAE; 3votesperson; Projected'eO EP

Soft Robe Arm

Anatrix
Cost estimate
ease of carted
stability Inequitable

ly

## durability

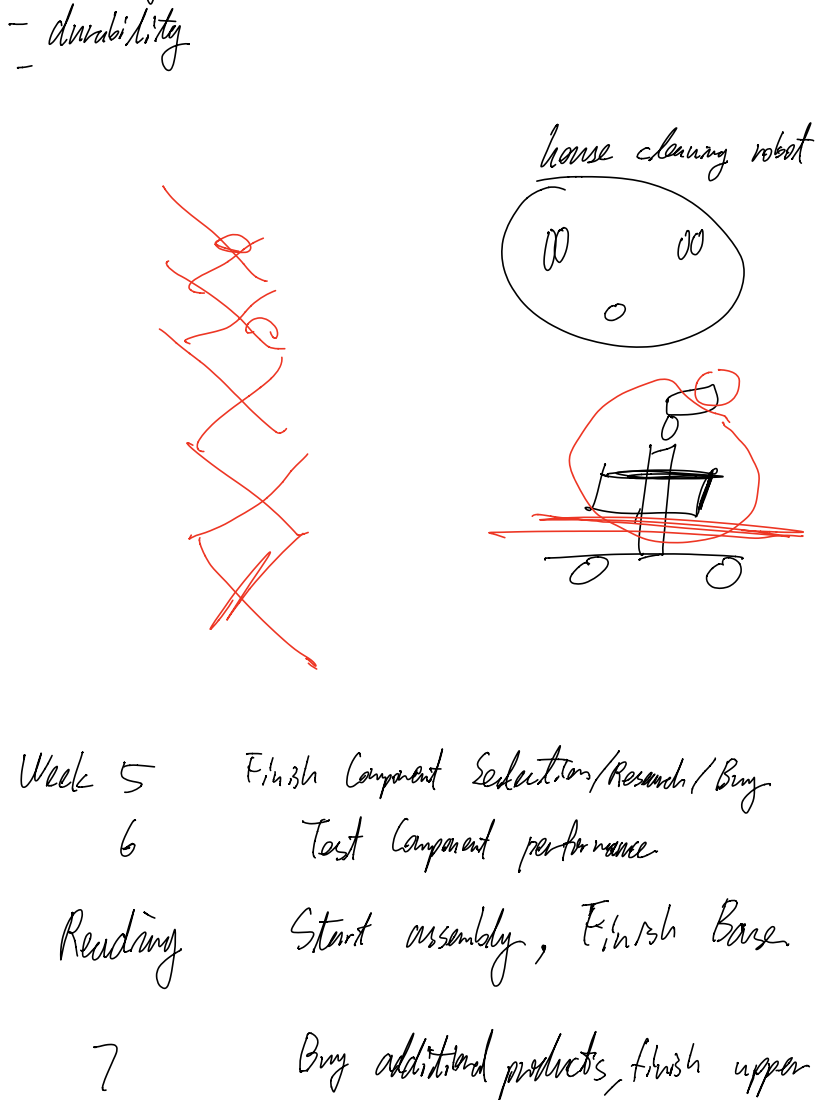
[picture p79: page 2]
house clean my; robot; EoEs; Week 5; Finish Component Sedat.tn Resamh Buy; Test Component performance; Reading; start assembly Finish Base; Buy additionalproducts finish upper

p
8 | Assembly

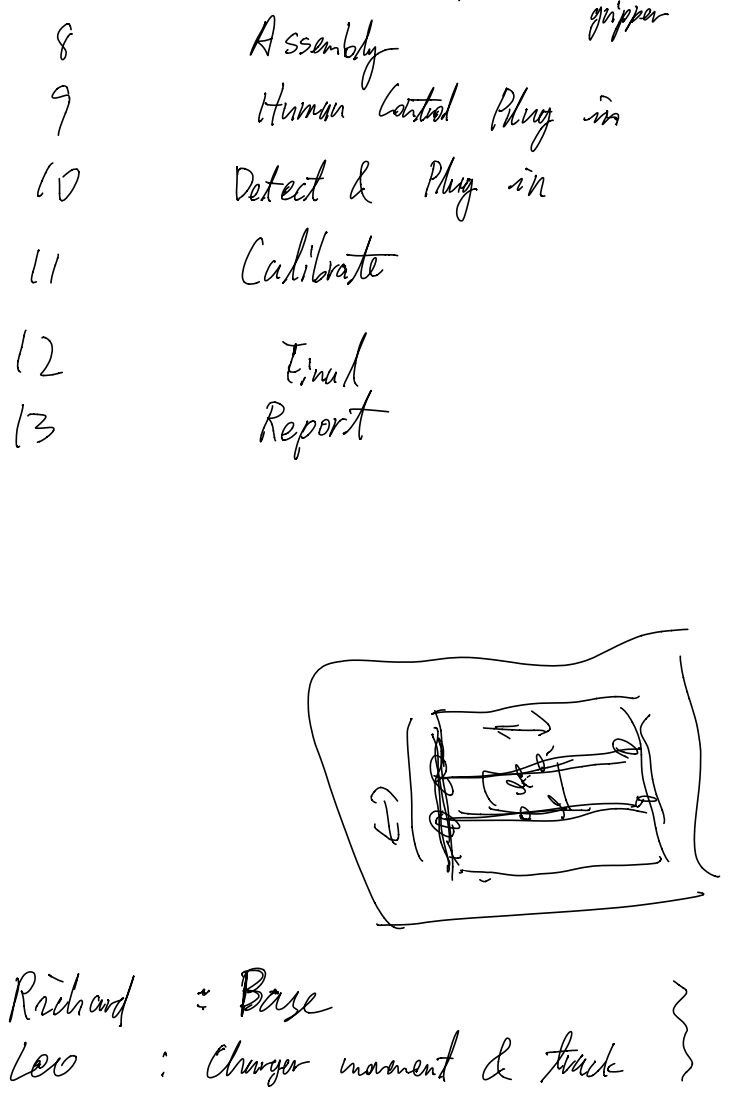
[picture p80: page 3]
gripper; Human Control Plug inn; Detect d Plug i; Calibrate; Final; Report; Richard; Base; too; i Charger movement; track

Mangin | Image detect
Senser | Camera

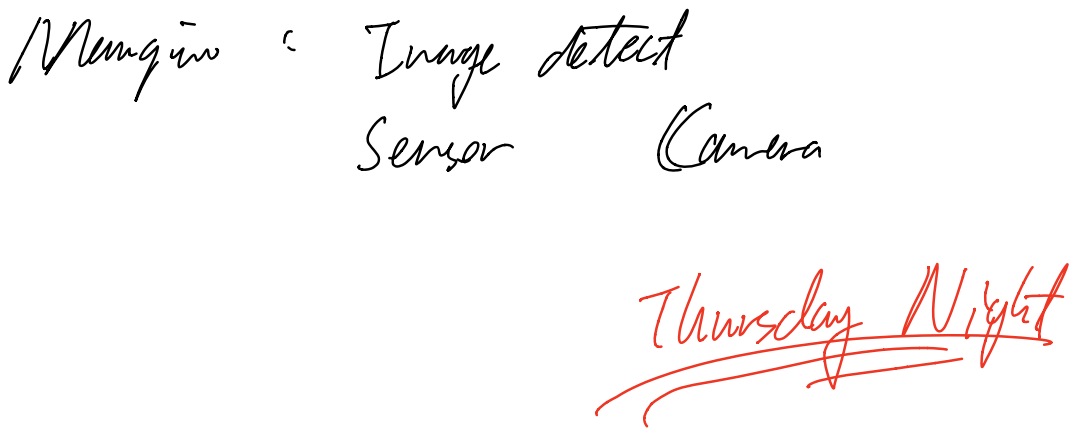
[picture p81: page 4]
ThyNeight
