haohao1331/ESC204-Team/project proposal/Motor calculations for lead screw.pdf

### Max height 60cm

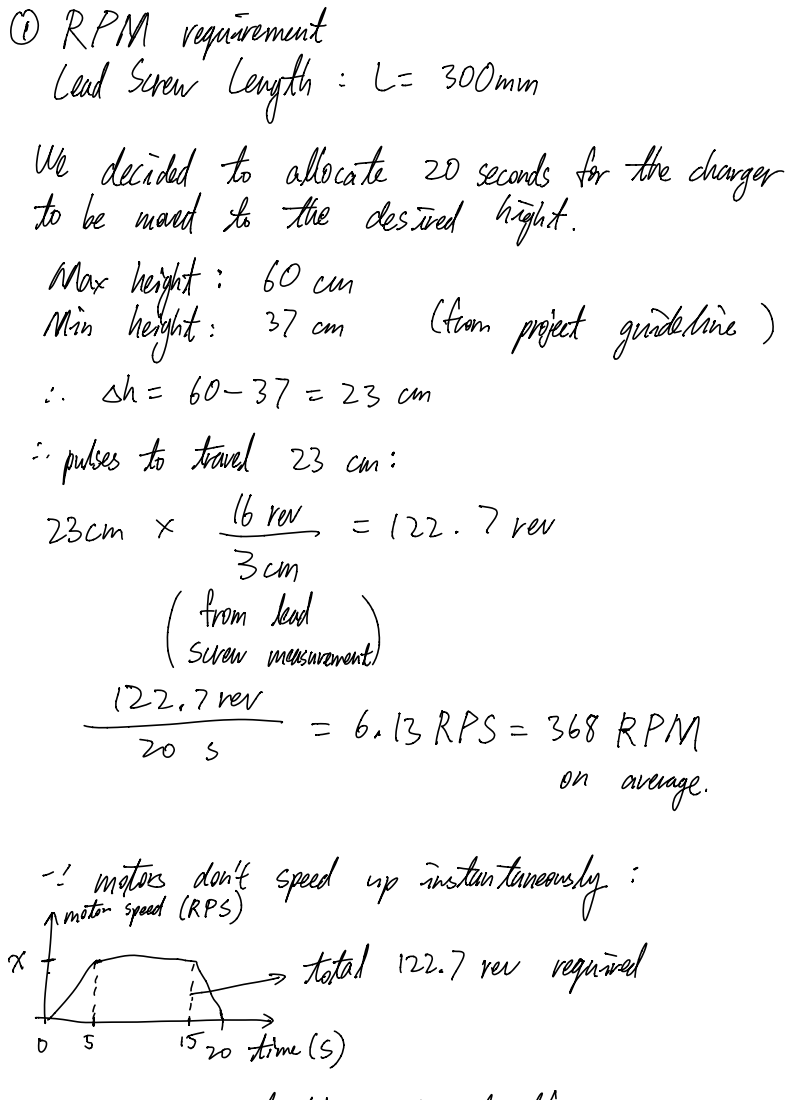
[picture p82: page 1]
RPM requirement; Lead Suren Length; Allin height; Hum project guideline; lbrW_ 122 7 rev; 3cm from dead; screw; measurement; 122.7 her; 6.13RPS 368 APAN; on average; no timeG; lerh

We decided to allocate 20 seconds forthe charger
to be moved to the desired Hight

pulses to travel 23 am

fEeacdfphs4y speed up instantaneously

total 122.7 rev required

## x 8.18RPS 490.8RPM

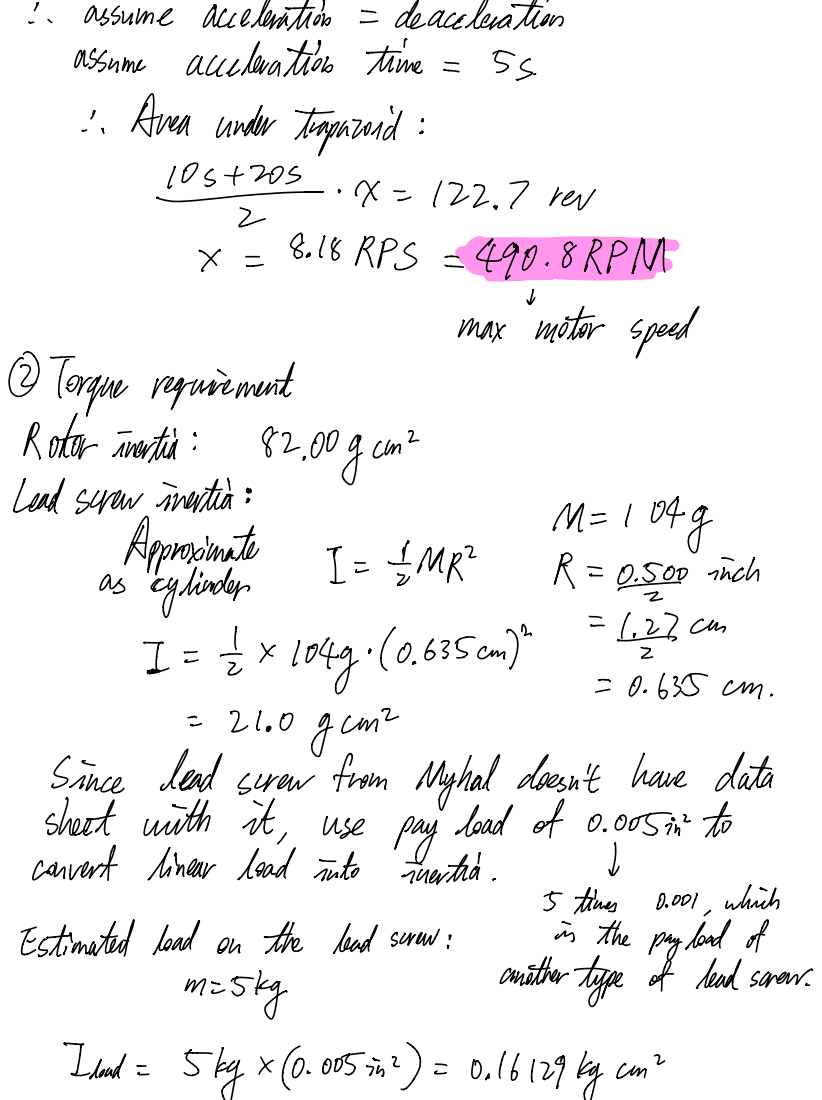
[picture p83: page 2]
assume acceleration; deaceleration; assume accelerations time; i Area under Taparoid; lost 205 2; 122.7 rev; Imaxmotor speed; Torque requirement; Rotorinertia; 82.00gun leadscrewinertia; Approximate; 104g Itzhak; A 0.500 mich as cylinder; 21.0 gumz; convert linear load into inertia; 5 times 0.001 which; Estimated lead on the leadscrew; in the payload of; mestag; 7dead

Since dead screw from Mughal doesn't have data
sheet with it use payload of aoosii to

anothertype of badsonar

g | g

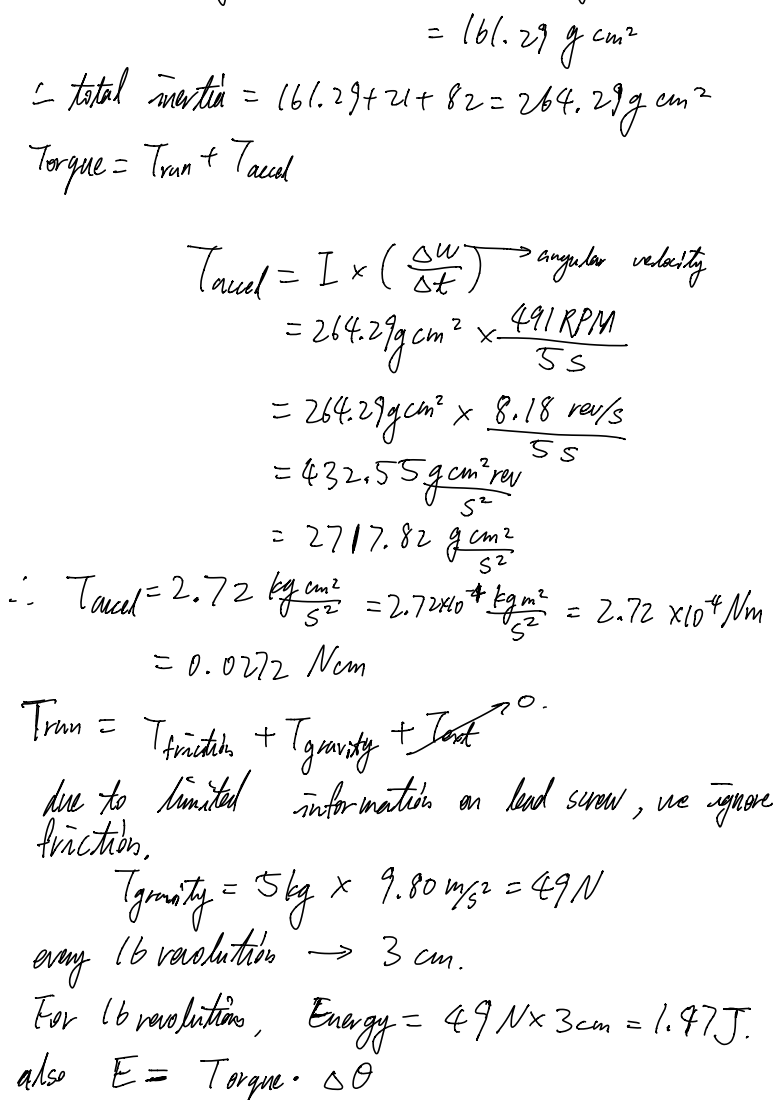
[picture p84: page 3]
161.29your; Torque TrantTanel; Tanel L x; FIT angular velocity; 264.29gcm; 5 s 264.29gun x8 ie s 432a55gIrw55 5; 2717.82 going; i Taxed 2.72 kymju; z.pro kggmI; 2n72xio⁴Nm; 0.0272 Nom; Tgmuity 5kg x 9.80 2; every 16revolution; For 16revolutions; Energy 49Nx 3cm 1.47J; also E; Torque OO

e total inertia 161.2ft ut 82 2h4 29gun

Trm Tfriation TTgravitytTextf

due to limited information on leadscrew we Ignore
friction

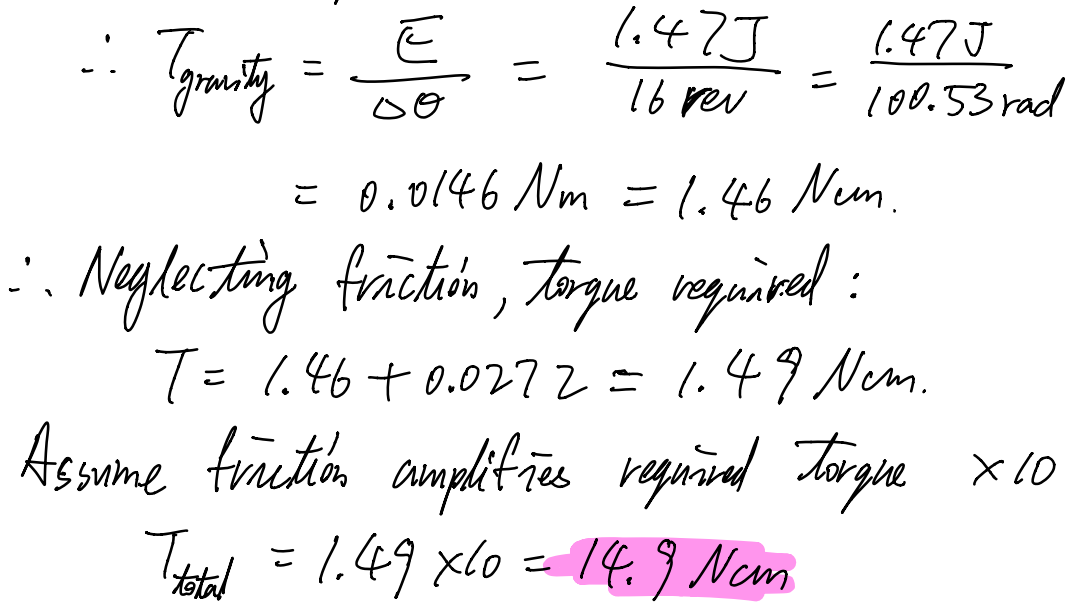
[picture p85: page 4]
Tgmuity; t.iewJ; 100.53rad; I 46Nun

i Neglecting friction torque required
T 1.46 10.0272 E l 49Nun
Assume friction amplifies required torque x to
Tata 1.49Ho 14.9Nom
