haohao1331/ESC204-Team/workshop2 deliverable/ESC204 workshop 2 deliverable process.pdf

## o.eu

# so f

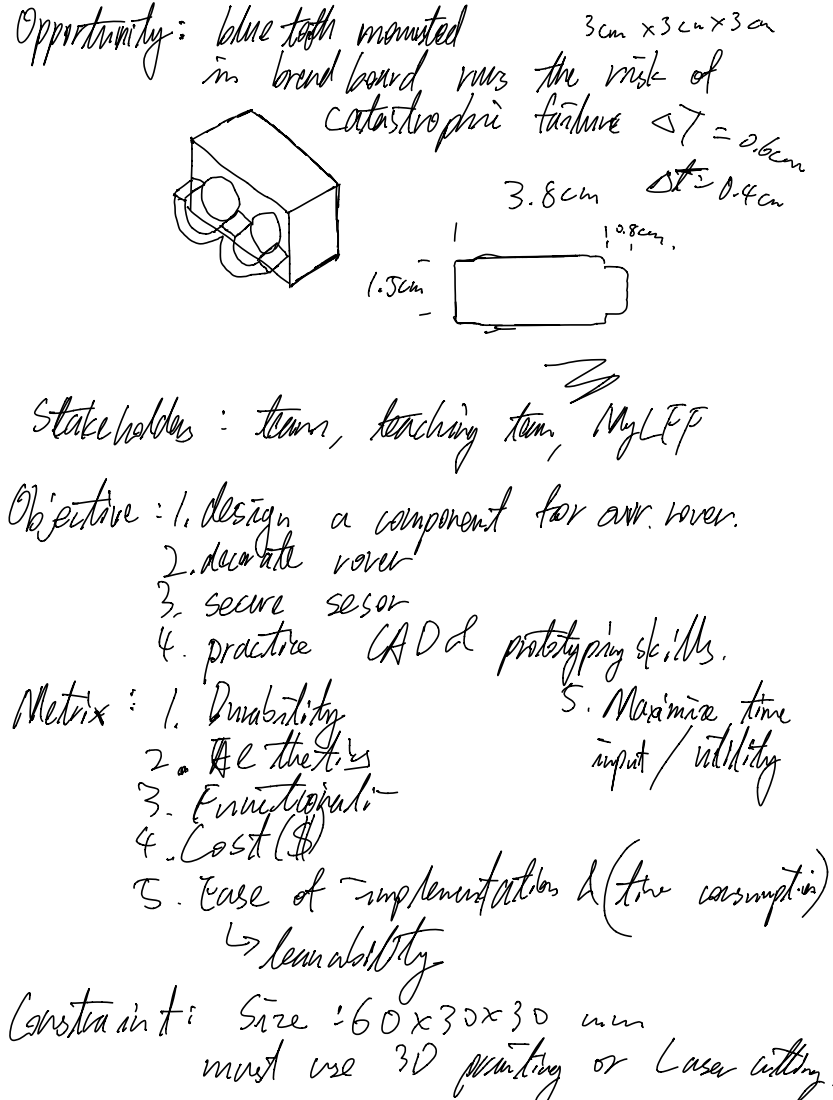
[picture p86: page 1]
Opportunity bluetooth emanated; 3cm Henna; stakeholders; team teaching team MyLEF; Matrix 1 Durability; 5 Maximise time; 2 EAethetts; inputfutility 3 Ennetoirali

in breadboard runs the risk of
ja tastrophri failure 0T

Objective 1 design a component for our never

2 decorate rover
3 secure seser
4 practice CADd prettypigskills

4 Cost
5 Ease ofimplementation dftiucasnupt.is
leanability

Gastonint sire 60 30 30 um

must use 3D printing or Lasercutting

### criteria

## Diverging

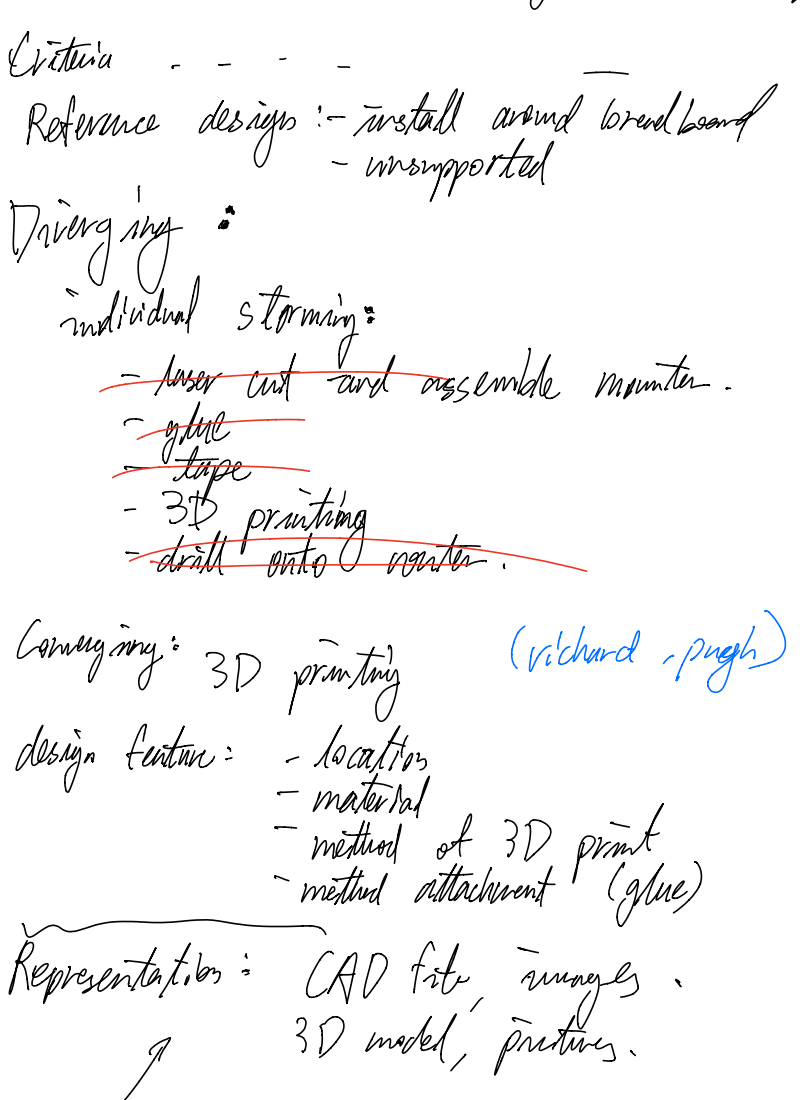
[picture p87: page 2]
unsupported; individual storming; Ivens; semble mounter; glut; tape 3D printing d; ttn; honeying 3D printing; richard pugh; design feature; location; material; method of 3D print methed attachment; glue; Representation; CAD file images; 3D model pictures

Reference design install around breadboard

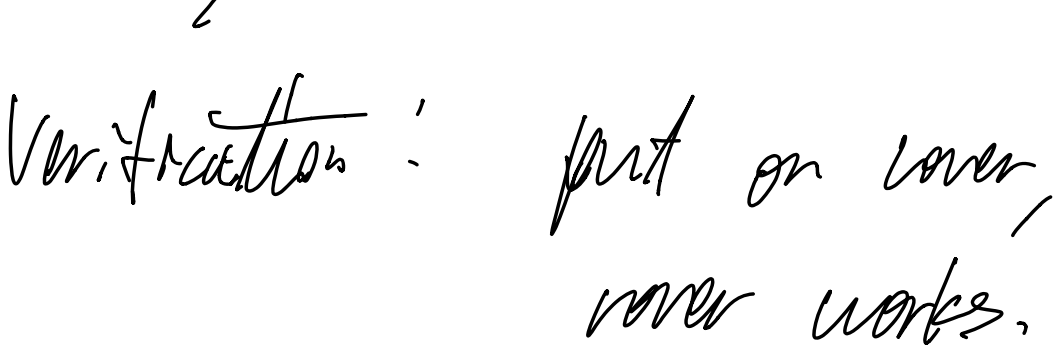
[picture p88: page 3]
Verification; put on loner; rover works
