haohao1331/ESC204-Team/milestone 2/Electrical/code for milestone 1/keyboard.py

import sys, termios, tty, os, time

def getch():
    fd = sys.stdin.fileno()
    old_settings = termios.tcgetattr(fd)
    try:
        tty.setraw(sys.stdin.fileno())
        ch = sys.stdin.read(1)

    finally:
        termios.tcsetattr(fd, termios.TCSADRAIN, old_settings)
    return ch
'''
while(True):
        char = getch()
        print(char)

        if(char==" "):
                break

print("input detection ended")
'''
