haohao1331/ESC204-Team/milestone 2/Mechanical/Mechanical Build/Build Process before Milestone 1/1 Finished Base Frame.JPG

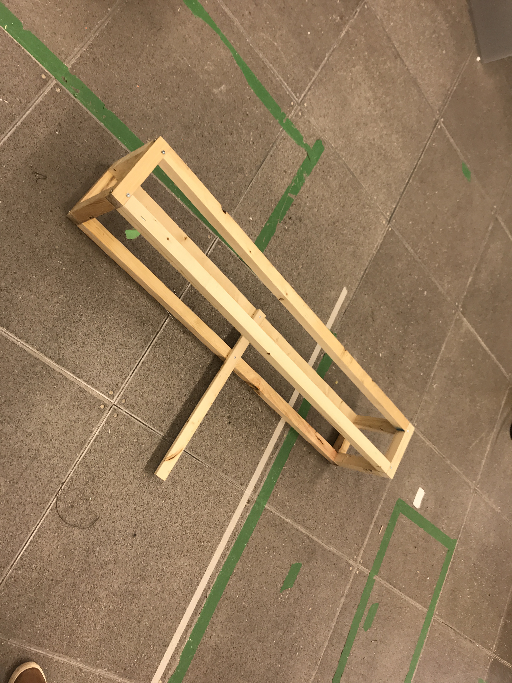
milestone 2/Mechanical/Mechanical Build/Build Process before Milestone 1/1 Finished Base Frame.JPG
